ymhtwe/stm32_timer_app/HW/foot_prints/PEC11R-4215F-S0024/ec11_rotary_encoder_knob_-yf-19-1.snapshot.2/EC11_knob.jpg

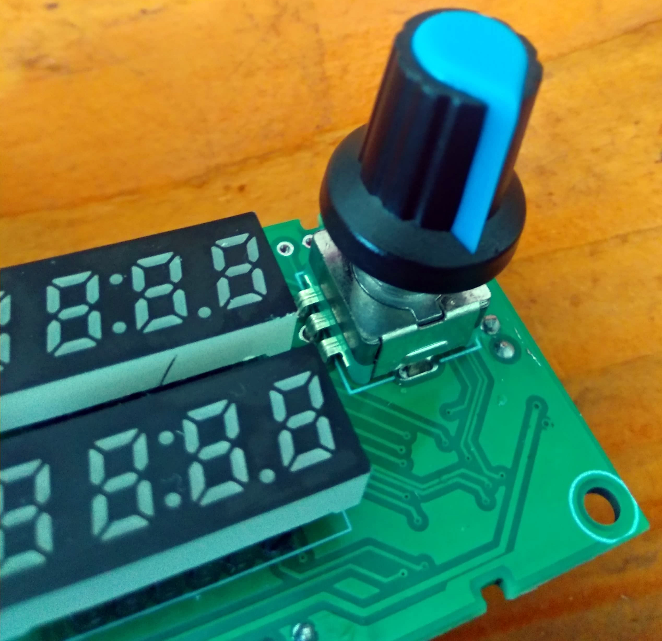
HW/foot_prints/PEC11R-4215F-S0024/ec11_rotary_encoder_knob_-yf-19-1.snapshot.2/EC11_knob.jpg
