ymhtwe/stm32_timer_app/HW/stm32_timer_app_front_pcb_layout.jpg

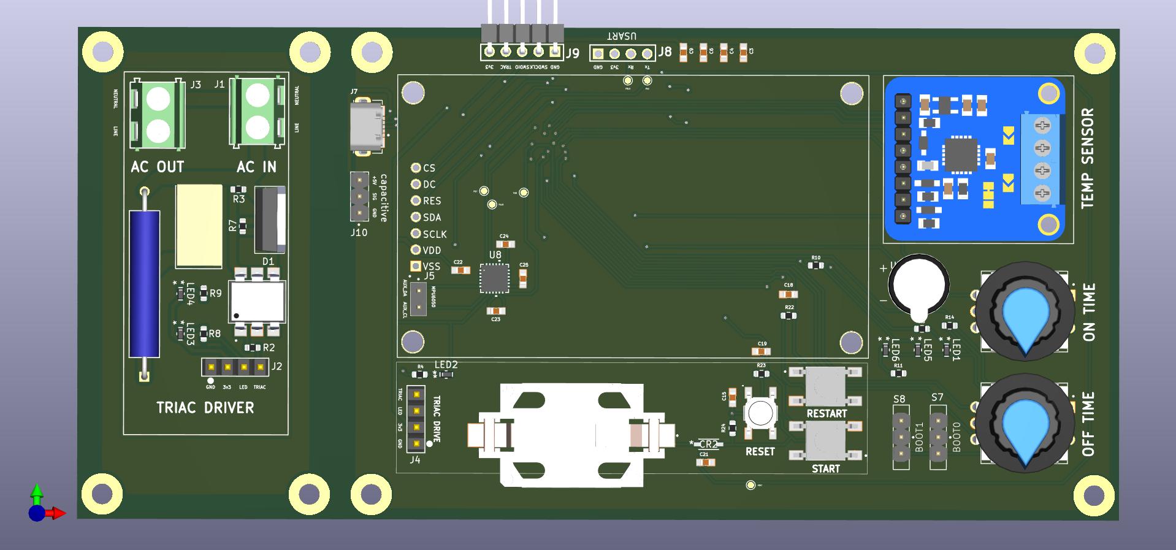
HW/stm32_timer_app_front_pcb_layout.jpg
