ymhtwe/stm32_timer_app/README.md

# stm32_timer_app
general purpose control applications using stm32 timer module
