ymhtwe/stm32_timer_app/Temp Control Timer.pdf

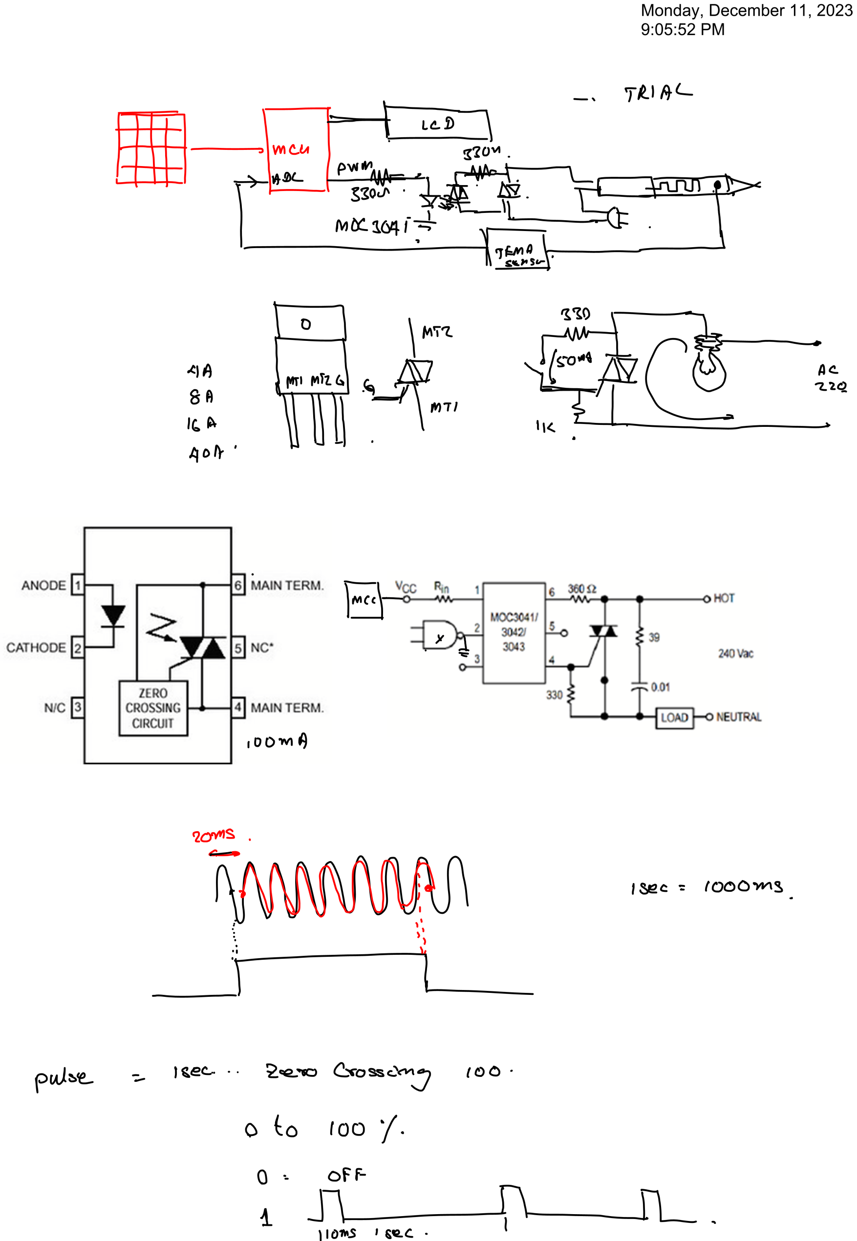
[picture p3: page 1]
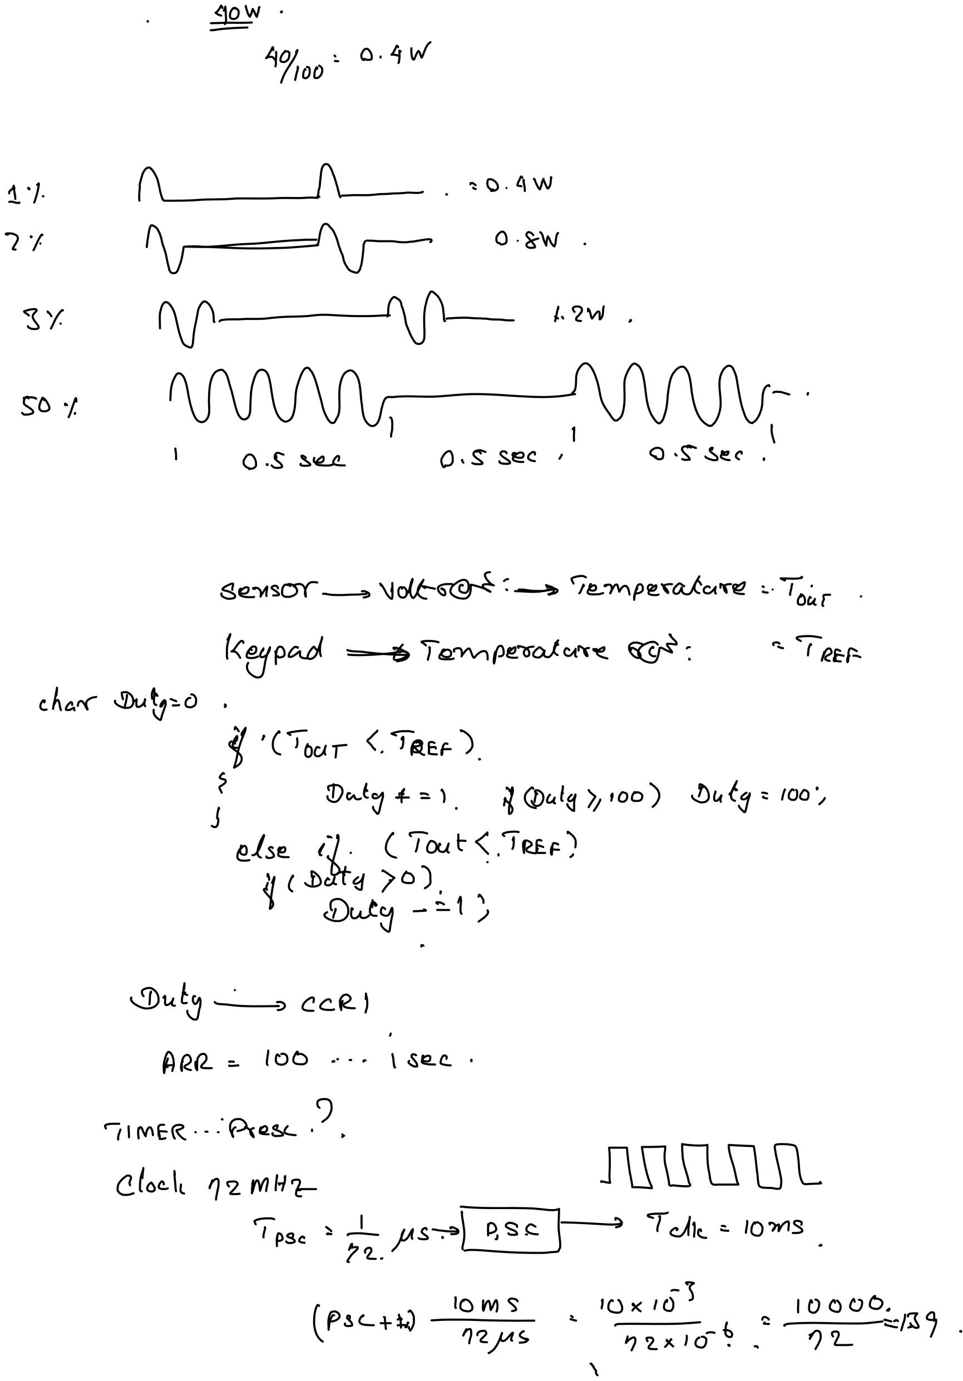
[picture p4: page 2]
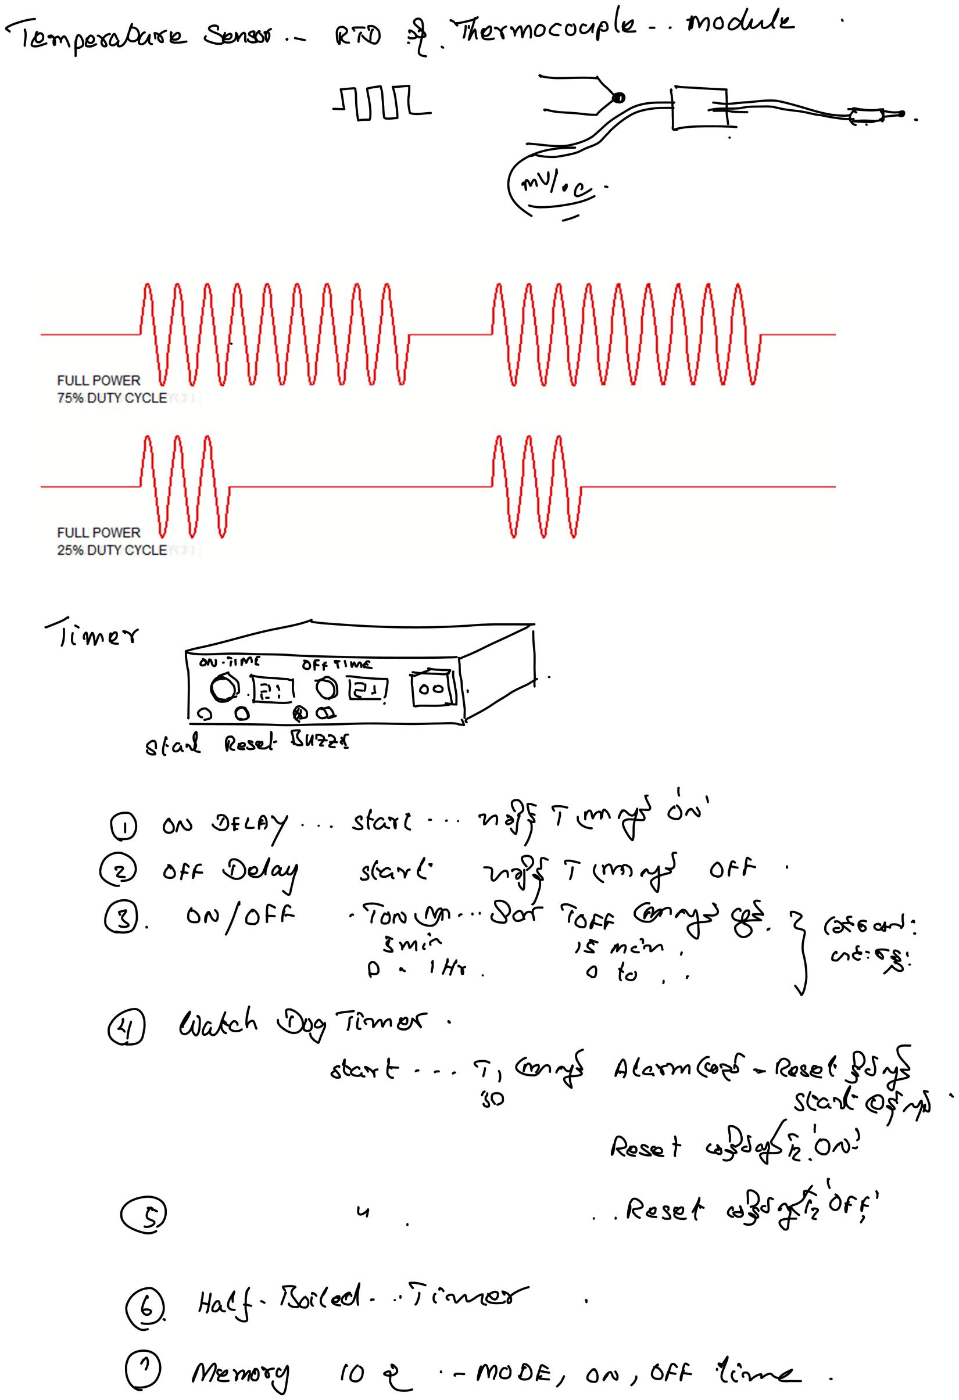
[picture p5: page 3]
