ymhtwe/stm32_timer_app/HW/stm32_timer_app/stm32_timer_app.jpg

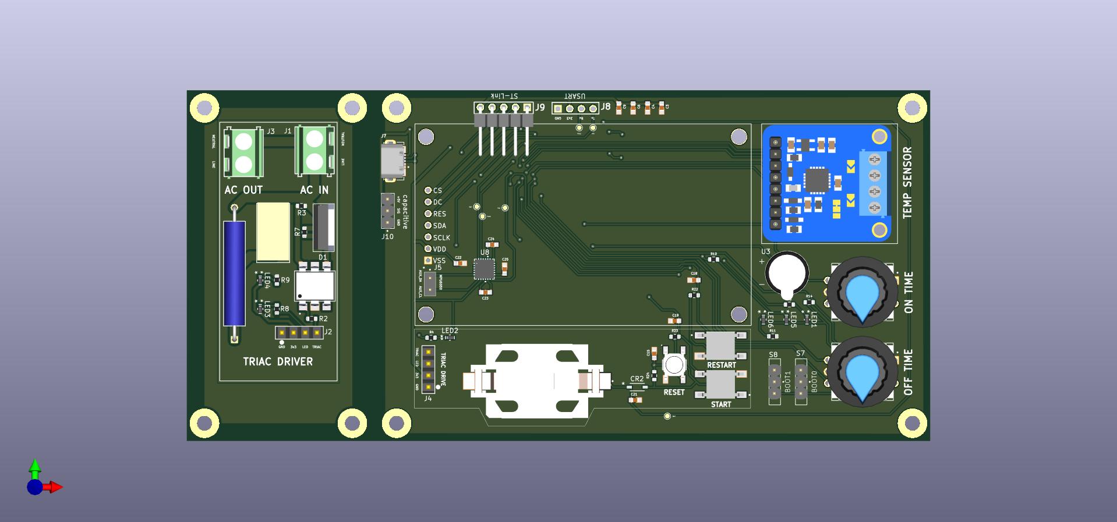
HW/stm32_timer_app/stm32_timer_app.jpg
