ymhtwe/stm32_timer_app/HW/foot_prints/150060GS75000/LED_150060GS75000_WRE.step

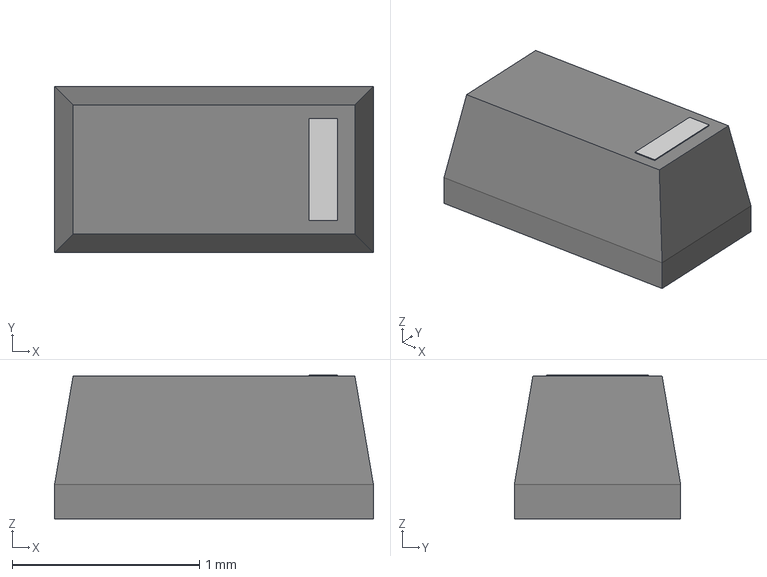
[picture p8: CAD file, 2023-12-16]
HW/foot_prints/150060GS75000/LED_150060GS75000_WRE.step
1.70 x 0.888 x 0.768 mm
