ymhtwe/stm32_timer_app/HW/foot_prints/1N4148W_13_F/SOD123_DIO.step

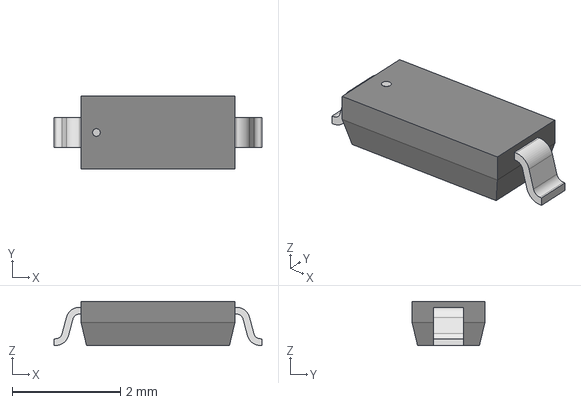
[picture p9: CAD file, 2023-12-17]
HW/foot_prints/1N4148W_13_F/SOD123_DIO.step
3.85 x 1.35 x 0.815 mm
