ymhtwe/stm32_timer_app/HW/foot_prints/2-42-12864-oled-display-1.snapshot.2/OLED 2.42 12864 v7.step

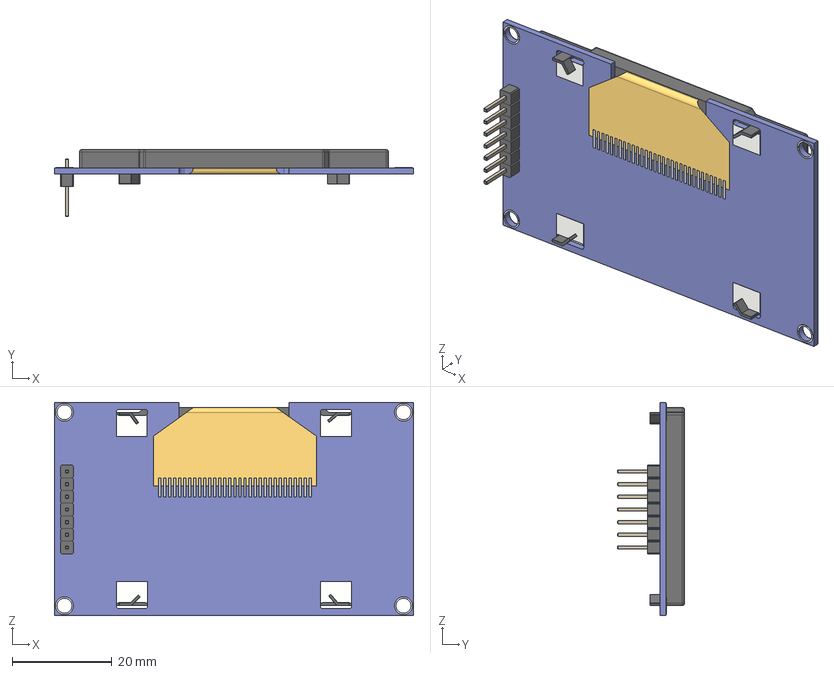
[picture p10: CAD file, 2023-12-21]
HW/foot_prints/2-42-12864-oled-display-1.snapshot.2/OLED 2.42 12864 v7.step
72.0 x 13.4 x 42.8 mm
screen
cable
PLS-7 v2
