ymhtwe/stm32_timer_app/HW/foot_prints/61300411121/CONN_61300411121_WRE.step

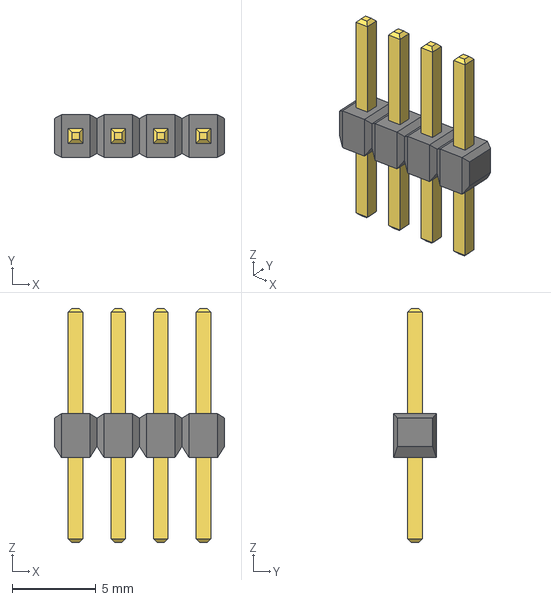
[picture p11: CAD file, 2023-12-16]
HW/foot_prints/61300411121/CONN_61300411121_WRE.step
10.2 x 2.54 x 14.0 mm
