ymhtwe/stm32_timer_app/HW/foot_prints/ABL-8.000MHZ-B2/ABL-8.000MHZ-B2.step

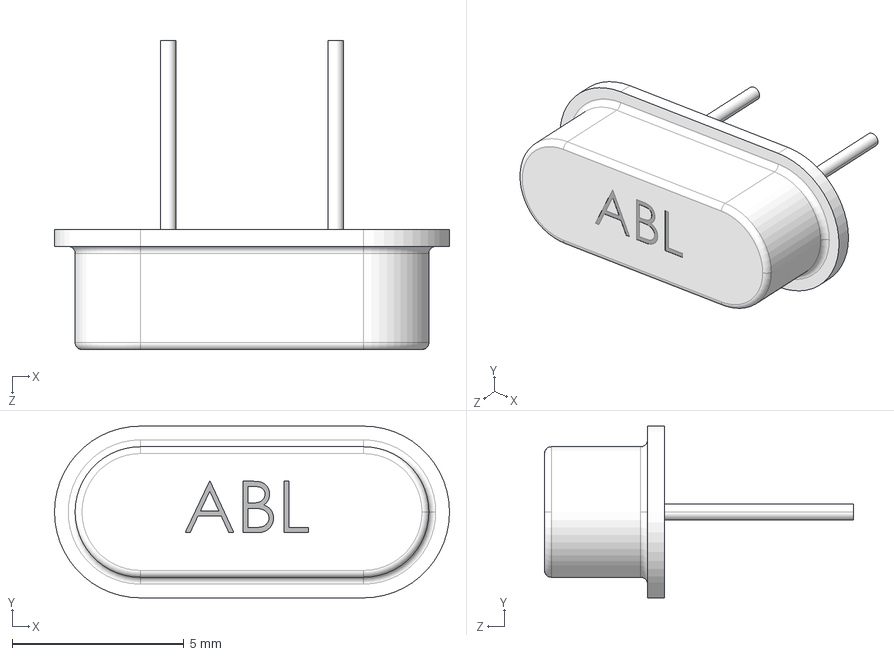
[picture p12: CAD file, 2023-12-17]
HW/foot_prints/ABL-8.000MHZ-B2/ABL-8.000MHZ-B2.step
11.5 x 5.00 x 9.00 mm
