ymhtwe/stm32_timer_app/HW/foot_prints/ABLS-8.000MHZ-B2-T/ABLS-8.000MHZ-B2-T.step

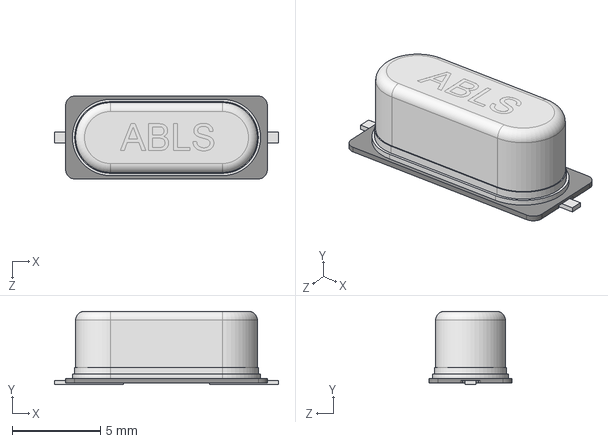
[picture p13: CAD file, 2023-12-21]
HW/foot_prints/ABLS-8.000MHZ-B2-T/ABLS-8.000MHZ-B2-T.step
12.7 x 4.17 x 4.70 mm
