ymhtwe/stm32_timer_app/HW/foot_prints/ABM3_8_000MHZ_J4Q_T/ABM3-8.000MHZ-J4Q-T.step

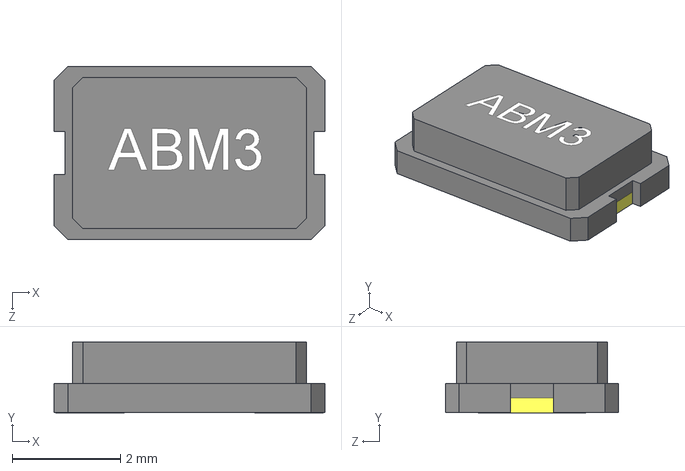
[picture p14: CAD file, 2023-12-25]
HW/foot_prints/ABM3_8_000MHZ_J4Q_T/ABM3-8.000MHZ-J4Q-T.step
5.00 x 1.30 x 3.20 mm
