ymhtwe/stm32_timer_app/HW/foot_prints/ABS07-32.768KHZ-T/ABS07-32.768KHZ-T.step

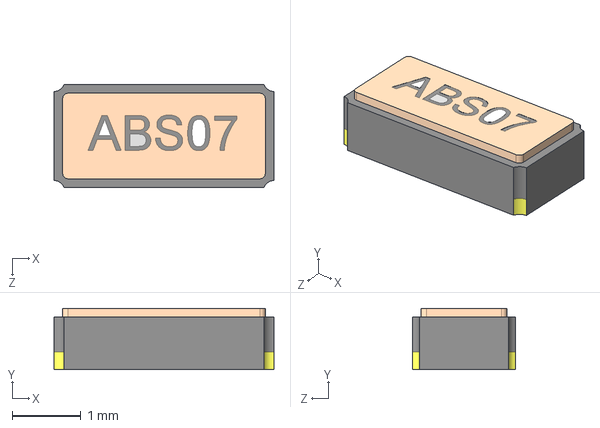
[picture p15: CAD file, 2023-12-25]
HW/foot_prints/ABS07-32.768KHZ-T/ABS07-32.768KHZ-T.step
3.20 x 0.889 x 1.50 mm
