ymhtwe/stm32_timer_app/HW/foot_prints/ABS25-32.768KHZ-6-4-T/ABS25-32.768KHZ-6-4-T.step

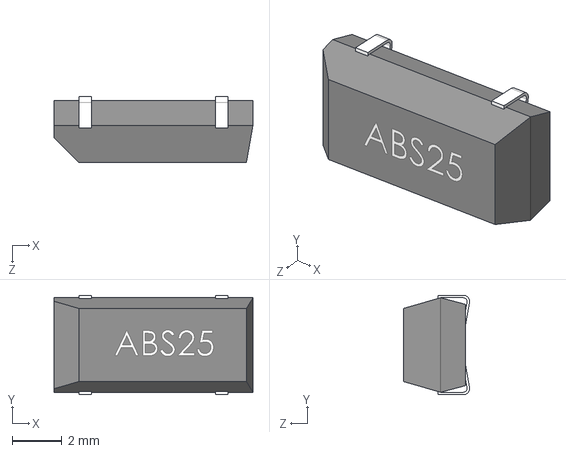
[picture p16: CAD file, 2023-12-17]
HW/foot_prints/ABS25-32.768KHZ-6-4-T/ABS25-32.768KHZ-6-4-T.step
8.00 x 4.00 x 2.66 mm
