ymhtwe/stm32_timer_app/HW/foot_prints/AI-1027-TWT-3V-R/AI-1027-TWT-3V-R.step

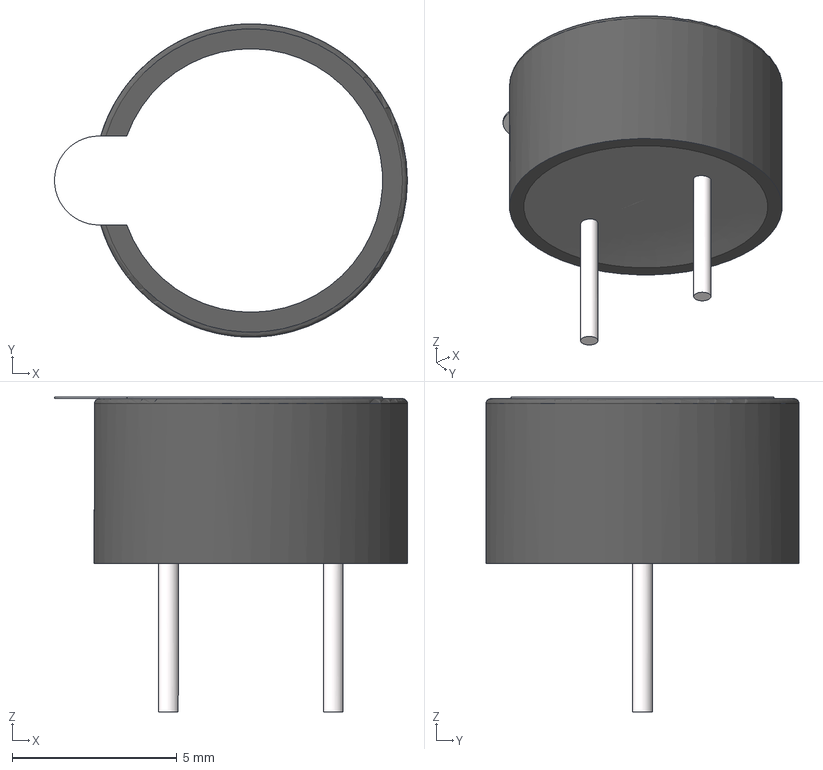
[picture p17: CAD file, 2023-12-23]
HW/foot_prints/AI-1027-TWT-3V-R/AI-1027-TWT-3V-R.step
10.7 x 9.50 x 9.55 mm
