ymhtwe/stm32_timer_app/HW/foot_prints/BTA16-600B/BTA16-600B.step

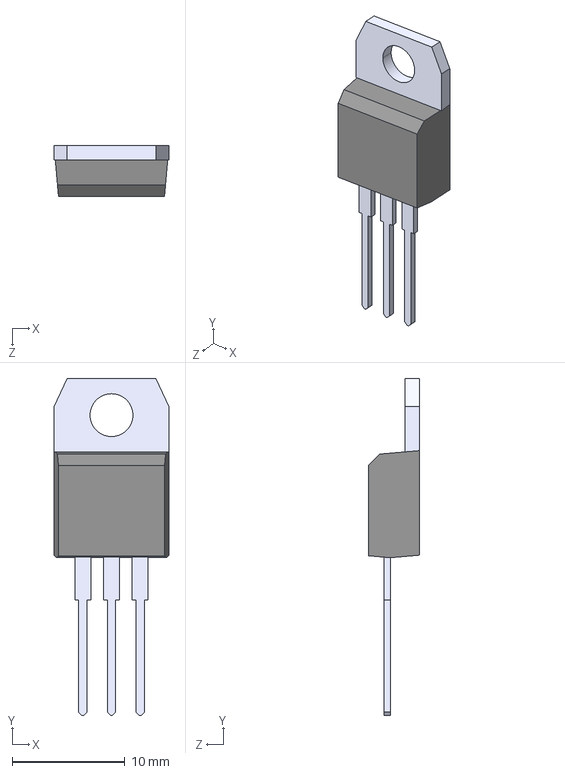
[picture p18: CAD file, 2023-12-16]
HW/foot_prints/BTA16-600B/BTA16-600B.step
10.2 x 29.9 x 4.50 mm
