ymhtwe/stm32_timer_app/HW/foot_prints/ECW_FD2J273KQ/CAP_ECWFD_FORMING_Q__12_6LX06_9TX09_9H_PAN.step

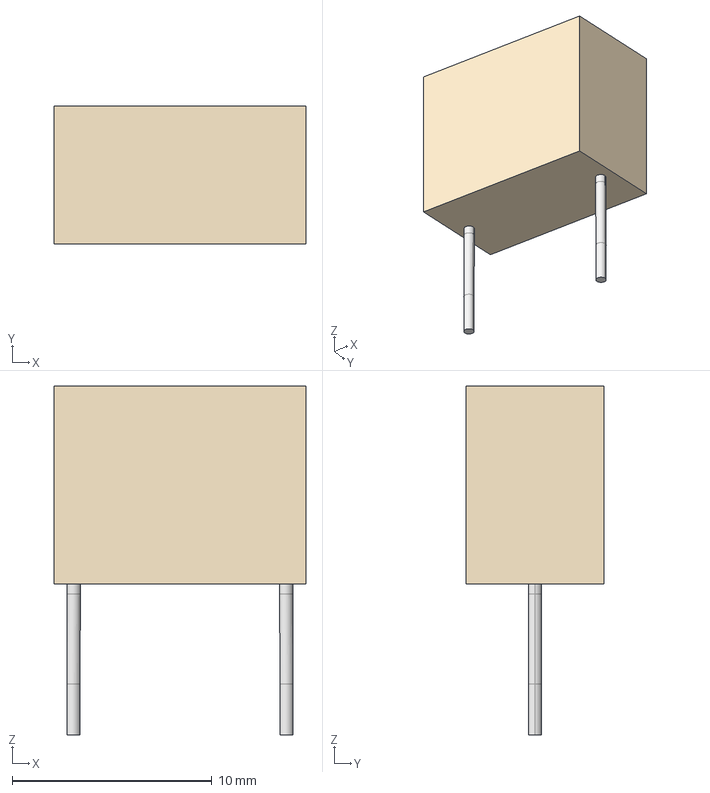
[picture p19: CAD file, 2023-12-17]
HW/foot_prints/ECW_FD2J273KQ/CAP_ECWFD_FORMING_Q__12_6LX06_9TX09_9H_PAN.step
12.6 x 6.91 x 17.4 mm
