ymhtwe/stm32_timer_app/HW/foot_prints/LD03ZD475MAB2A/LD03ZD475MAB2A.step

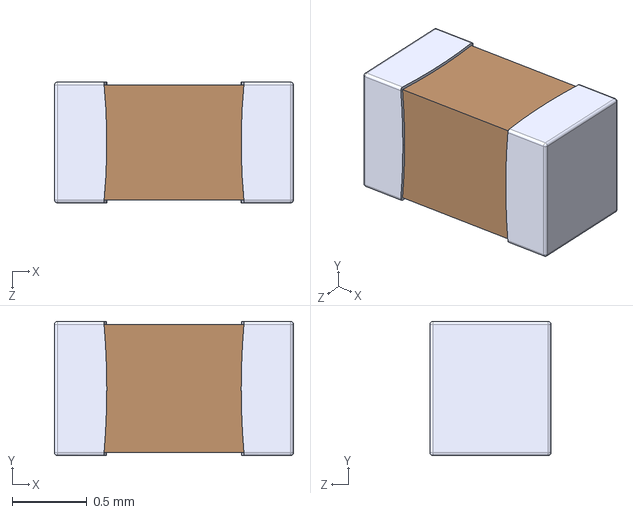
[picture p20: CAD file, 2023-12-16]
HW/foot_prints/LD03ZD475MAB2A/LD03ZD475MAB2A.step
1.60 x 0.9 x 0.81 mm
