ymhtwe/stm32_timer_app/HW/foot_prints/MMBT2222A-7-F/MMBT2222A-7-F.step

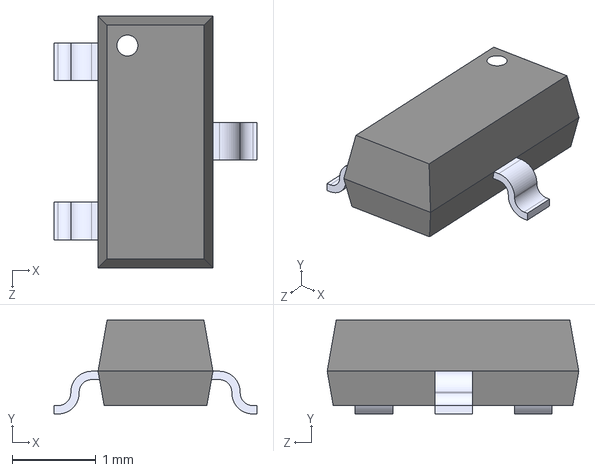
[picture p21: CAD file, 2023-12-23]
HW/foot_prints/MMBT2222A-7-F/MMBT2222A-7-F.step
2.42 x 1.12 x 3.00 mm
