ymhtwe/stm32_timer_app/HW/foot_prints/MOC3041/MOC3041.step

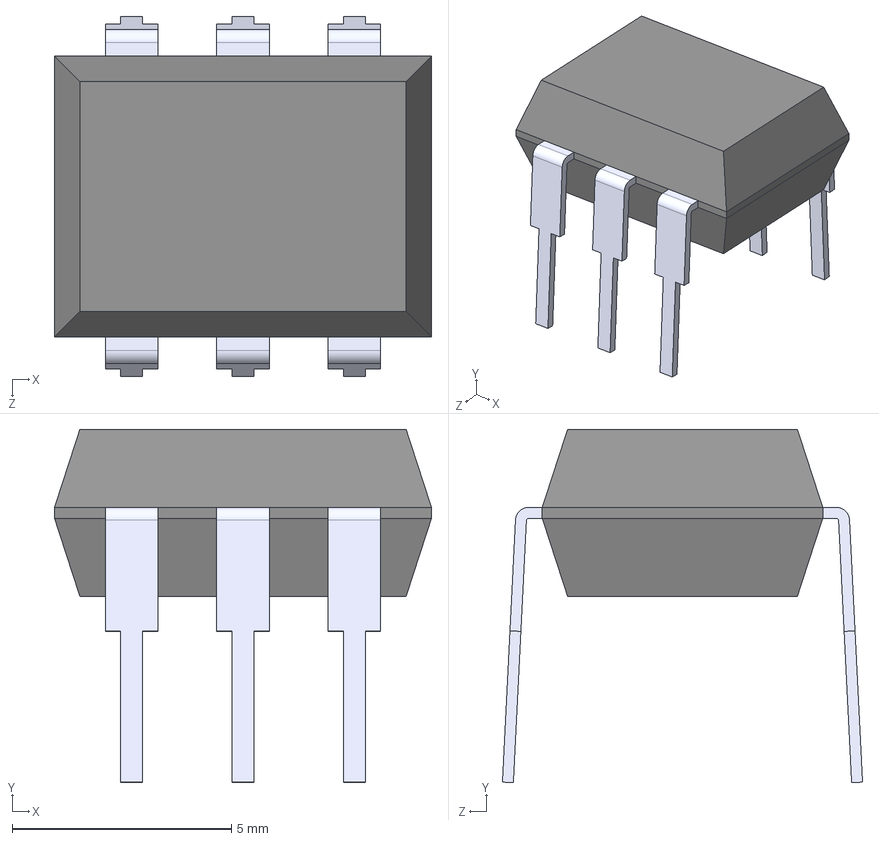
[picture p22: CAD file, 2023-12-16]
HW/foot_prints/MOC3041/MOC3041.step
8.60 x 8.06 x 8.21 mm
