ymhtwe/stm32_timer_app/HW/foot_prints/MOC3041SM/MOC3041SM.step

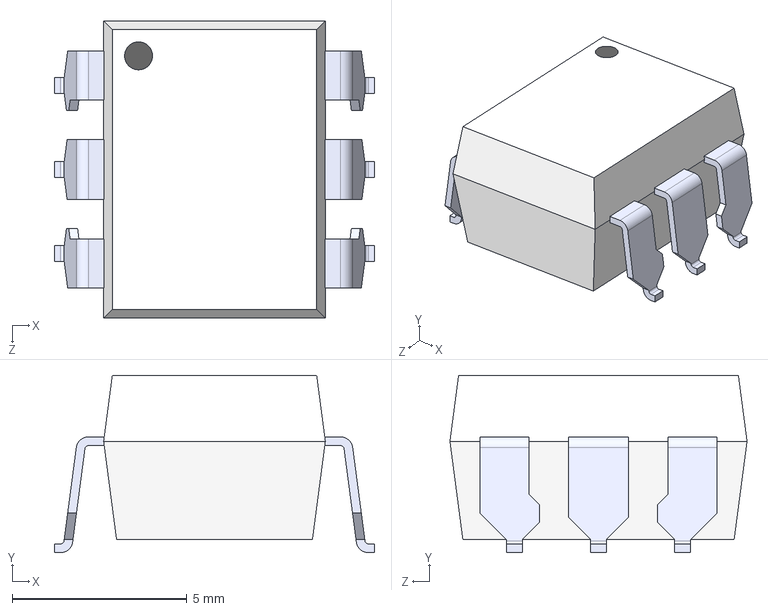
[picture p23: CAD file, 2023-12-16]
HW/foot_prints/MOC3041SM/MOC3041SM.step
9.16 x 5.08 x 8.51 mm
