ymhtwe/stm32_timer_app/HW/foot_prints/MPU_6050/QFN24_4X4X0P9_IVS.step

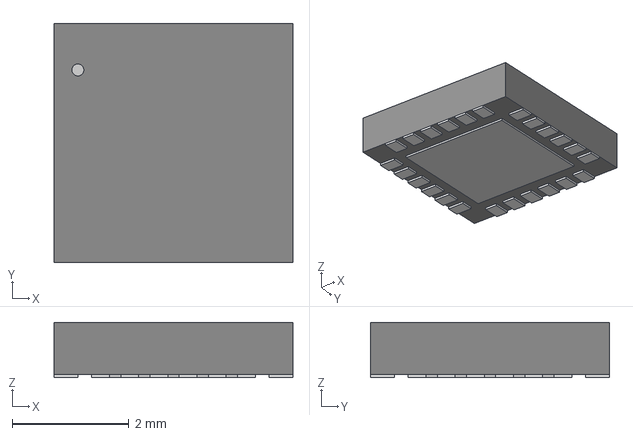
[picture p24: CAD file, 2024-01-13]
HW/foot_prints/MPU_6050/QFN24_4X4X0P9_IVS.step
4.09 x 4.09 x 0.942 mm
