ymhtwe/stm32_timer_app/HW/foot_prints/MSS-102559-14A-D/MSS-102559-14A-D.stp

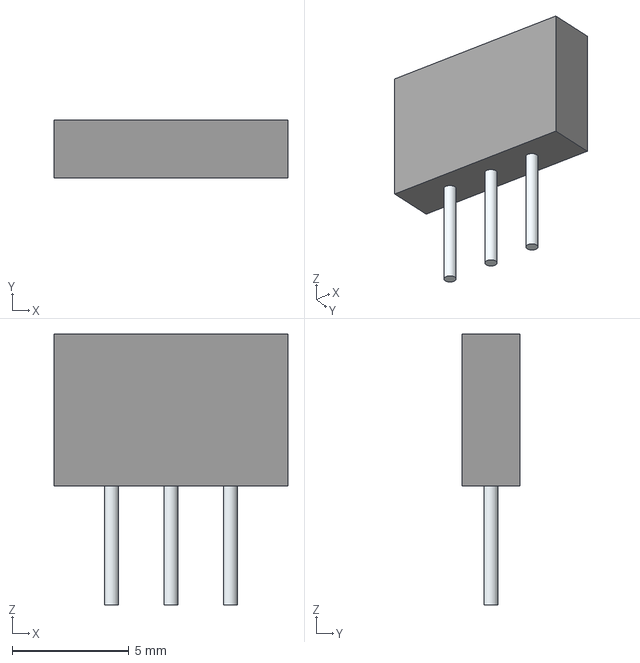
[picture p25: CAD file, 2023-12-25]
HW/foot_prints/MSS-102559-14A-D/MSS-102559-14A-D.stp
10.0 x 2.50 x 11.6 mm
Leads
