ymhtwe/stm32_timer_app/HW/foot_prints/MSS6-V-T_R/MSS6-V-T_R.step

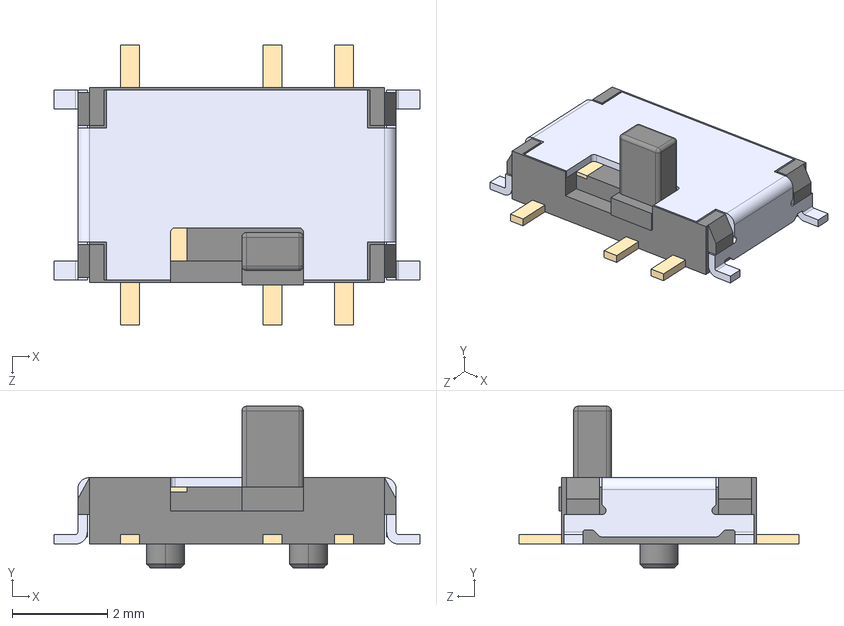
[picture p26: CAD file, 2023-12-21]
HW/foot_prints/MSS6-V-T_R/MSS6-V-T_R.step
7.70 x 3.40 x 5.90 mm
