ymhtwe/stm32_timer_app/HW/foot_prints/OY390KE/RES_OY_OHM.step

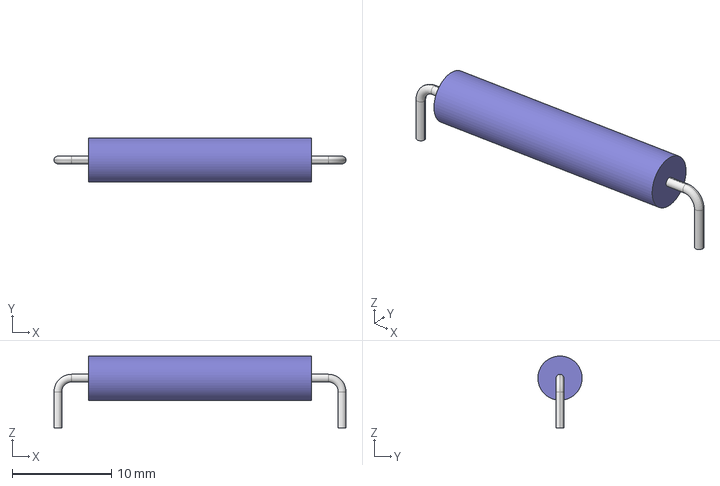
[picture p27: CAD file, 2023-12-17]
HW/foot_prints/OY390KE/RES_OY_OHM.step
29.5 x 4.47 x 7.26 mm
