ymhtwe/stm32_timer_app/HW/foot_prints/PEC11R-4215F-S0024/ec11_rotary_encoder_knob_-yf-19-1.snapshot.2/EC11_rotary_encoder_knob/EC11_rotary_encoder_knob.stp

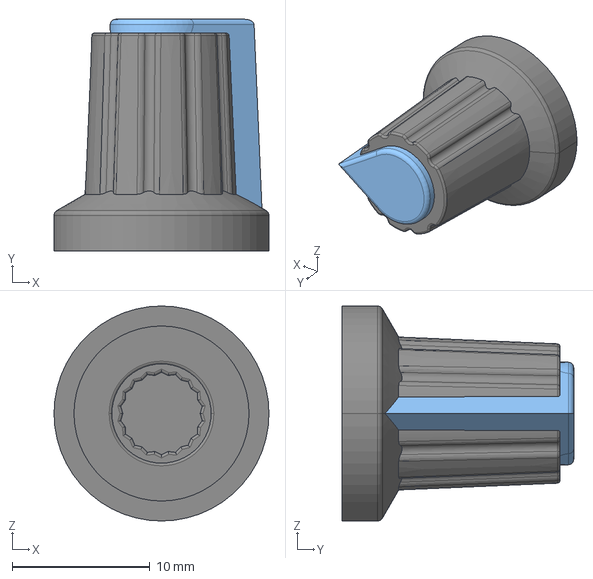
[picture p28: CAD file, 2023-12-25]
HW/foot_prints/PEC11R-4215F-S0024/ec11_rotary_encoder_knob_-yf-19-1.snapshot.2/EC11_rotary_encoder_knob/EC11_rotary_encoder_knob.stp
15.6 x 16.8 x 15.6 mm
