ymhtwe/stm32_timer_app/HW/foot_prints/PEC11R-4215F-S0024/PEC11R-4215F-S0024.step

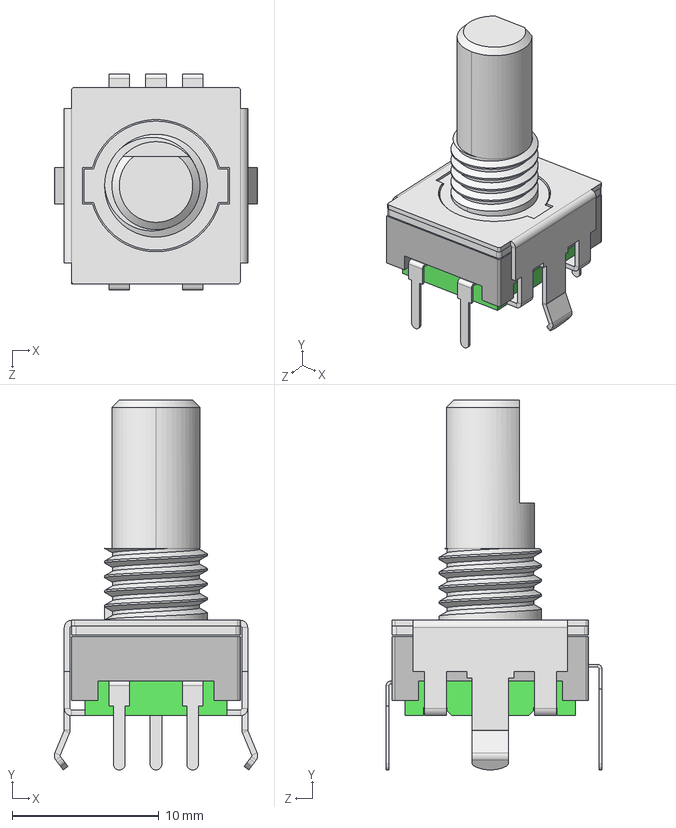
[picture p29: CAD file, 2023-12-16]
HW/foot_prints/PEC11R-4215F-S0024/PEC11R-4215F-S0024.step
13.9 x 25.2 x 14.7 mm
