ymhtwe/stm32_timer_app/HW/foot_prints/PH1RB-04-UA/PH1RB-04-UA.stp

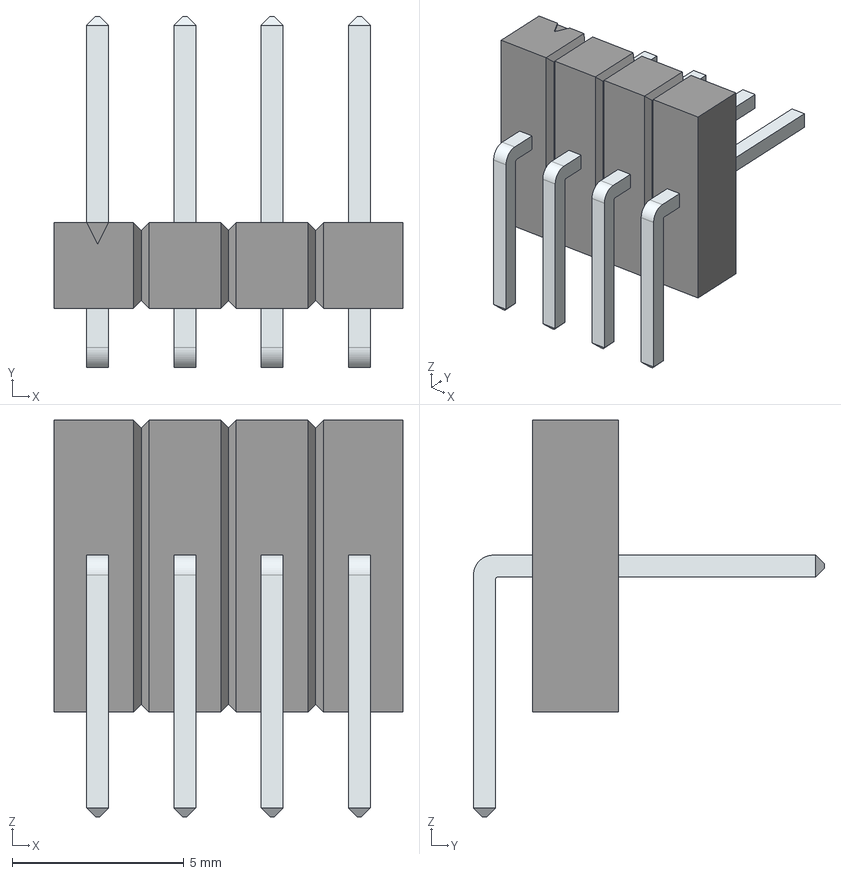
[picture p30: CAD file, 2024-01-13]
HW/foot_prints/PH1RB-04-UA/PH1RB-04-UA.stp
10.2 x 10.2 x 11.6 mm
LeadsArray
