ymhtwe/stm32_timer_app/HW/foot_prints/PH1RB-05-UA_TEMP/PH1RB-05-UA_TEMP..stp

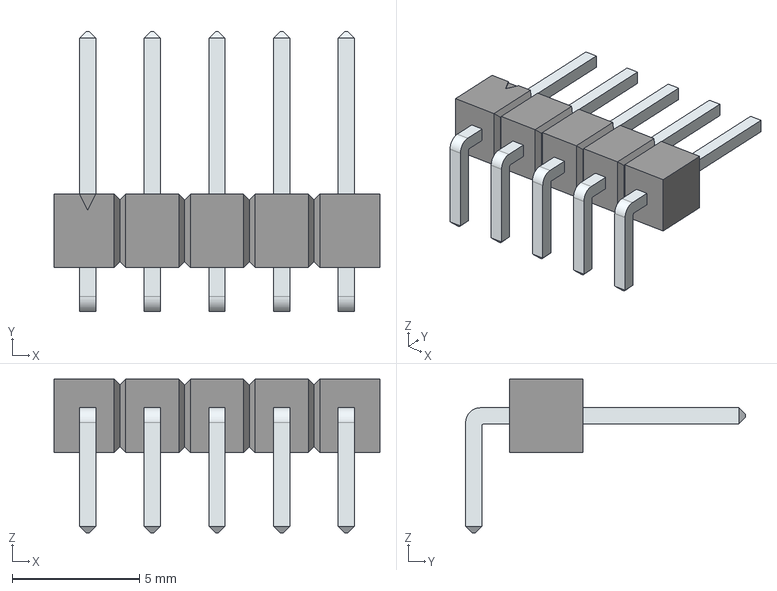
[picture p31: CAD file, 2024-01-13]
HW/foot_prints/PH1RB-05-UA_TEMP/PH1RB-05-UA_TEMP..stp
12.8 x 11.0 x 6.03 mm
LeadsArray
