ymhtwe/stm32_timer_app/HW/foot_prints/PH2_06_UA/CONN_PH2-06-UA_ADM.step

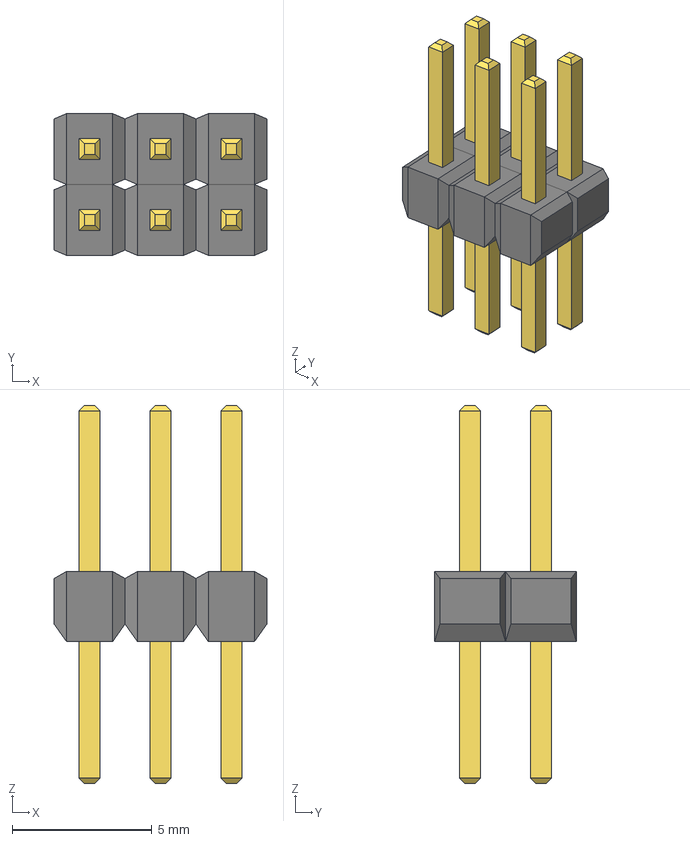
[picture p32: CAD file, 2023-12-16]
HW/foot_prints/PH2_06_UA/CONN_PH2-06-UA_ADM.step
7.62 x 5.08 x 13.5 mm
