ymhtwe/stm32_timer_app/HW/foot_prints/RC1206FR_0728RL/RC1206N_YAG.step

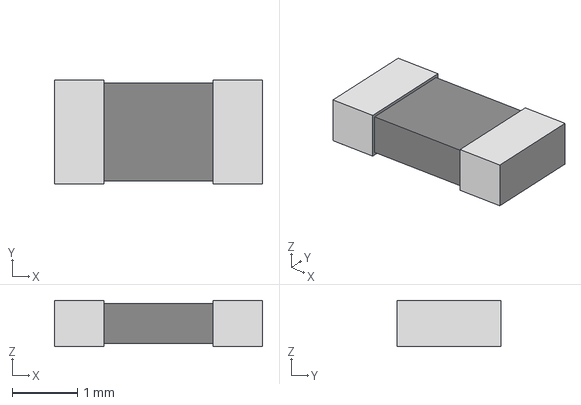
[picture p33: CAD file, 2024-01-13]
HW/foot_prints/RC1206FR_0728RL/RC1206N_YAG.step
3.20 x 1.60 x 0.711 mm
