ymhtwe/stm32_timer_app/HW/foot_prints/RC1602B-BIW-CSV/RC1602B-BIW-CSV.step

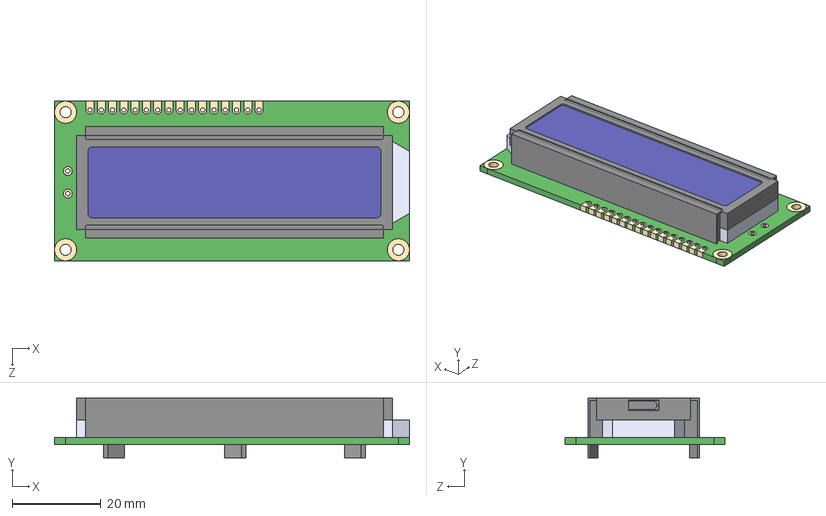
[picture p34: CAD file, 2023-12-16]
HW/foot_prints/RC1602B-BIW-CSV/RC1602B-BIW-CSV.step
80.0 x 13.5 x 36.0 mm
