ymhtwe/stm32_timer_app/HW/foot_prints/RT9193_33GB/RT9193-33GB.step

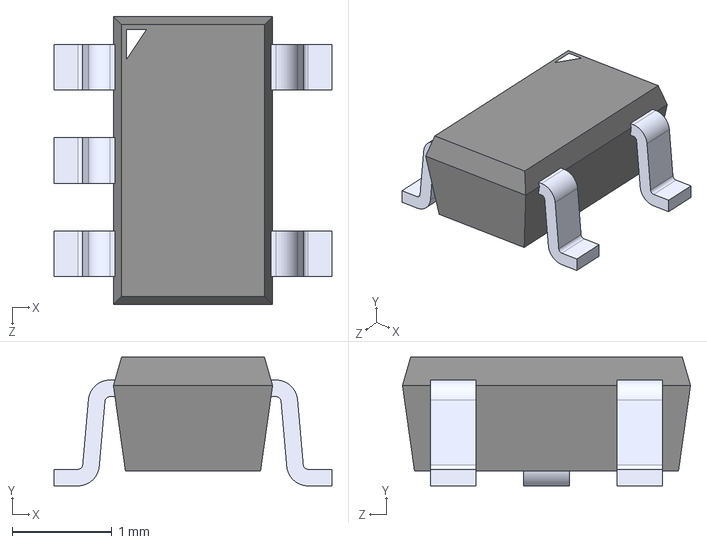
[picture p35: CAD file, 2023-12-16]
HW/foot_prints/RT9193_33GB/RT9193-33GB.step
2.79 x 1.30 x 2.90 mm
