ymhtwe/stm32_timer_app/HW/foot_prints/SMTU2032-LF/SMTU2032.step

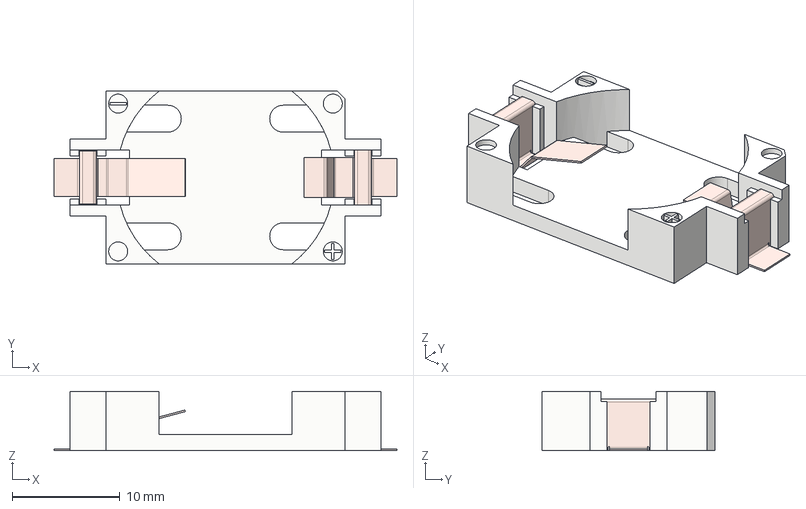
[picture p36: CAD file, 2023-12-28]
HW/foot_prints/SMTU2032-LF/SMTU2032.step
31.8 x 16.0 x 5.50 mm
base
connector_plus
connector_minus
