ymhtwe/stm32_timer_app/HW/foot_prints/STM32F103C8T6/STM32F103C8T6--3DModel-STEP-510211.STEP

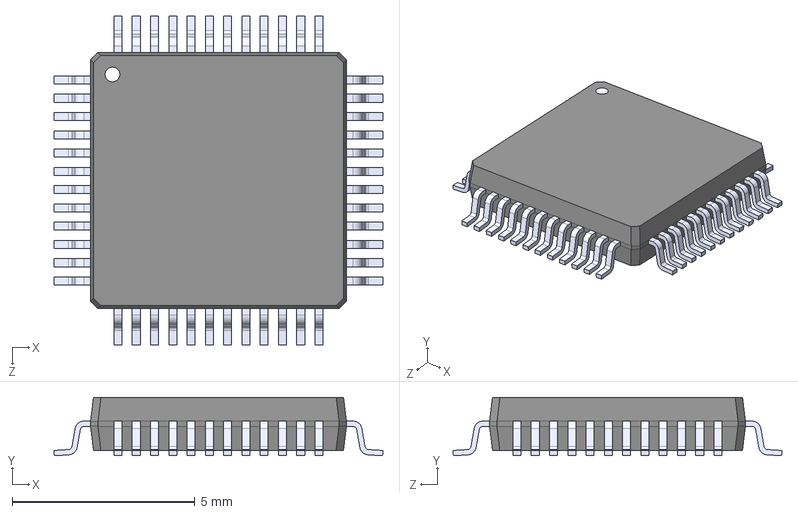
[picture p37: CAD file, 2023-12-16]
HW/foot_prints/STM32F103C8T6/STM32F103C8T6--3DModel-STEP-510211.STEP
9.00 x 1.60 x 9.00 mm
