ymhtwe/stm32_timer_app/HW/foot_prints/STM32f303C8T6/STM32F303C8T6.stp

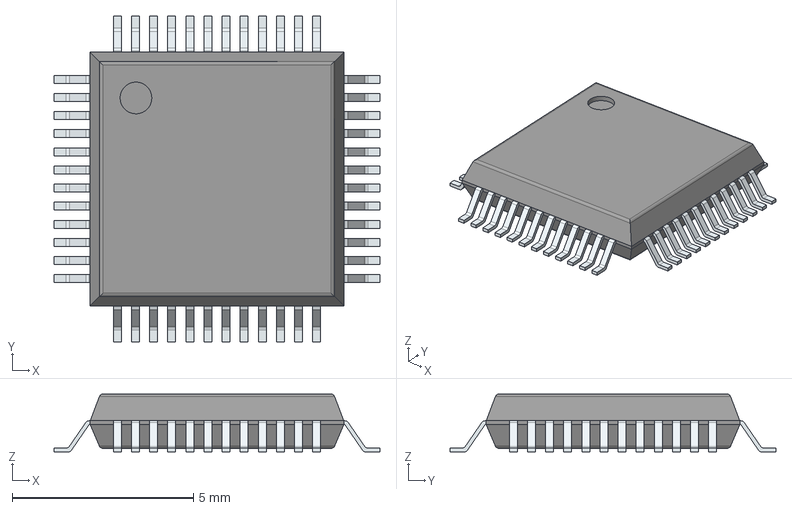
[picture p38: CAD file, 2023-12-28]
HW/foot_prints/STM32f303C8T6/STM32F303C8T6.stp
9.00 x 9.00 x 1.60 mm
PinsArrayLR
PinsArrayTB
