ymhtwe/stm32_timer_app/HW/foot_prints/TC33X_2_102E/TC33X-2-102E.step

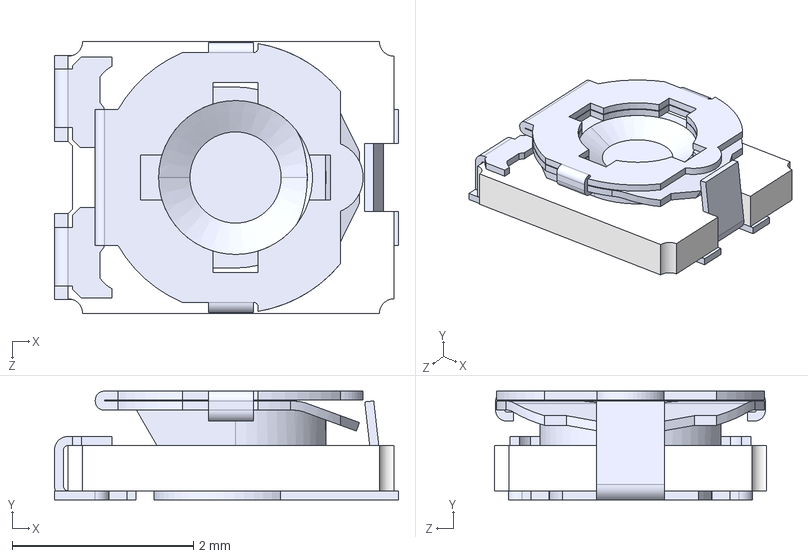
[picture p39: CAD file, 2023-12-17]
HW/foot_prints/TC33X_2_102E/TC33X-2-102E.step
3.80 x 1.20 x 3.00 mm
