ymhtwe/stm32_timer_app/HW/foot_prints/TL3342F160QG/TL3342F160QG.step

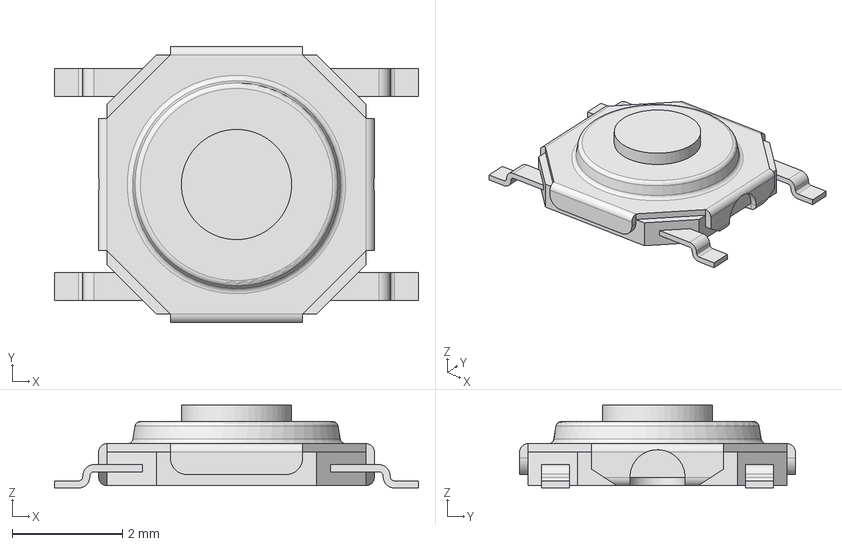
[picture p40: CAD file, 2023-12-21]
HW/foot_prints/TL3342F160QG/TL3342F160QG.step
6.60 x 5.00 x 1.50 mm
