ymhtwe/stm32_timer_app/HW/foot_prints/PH1RB-05-UA_TEMP/PH1RB-05-UA.STL

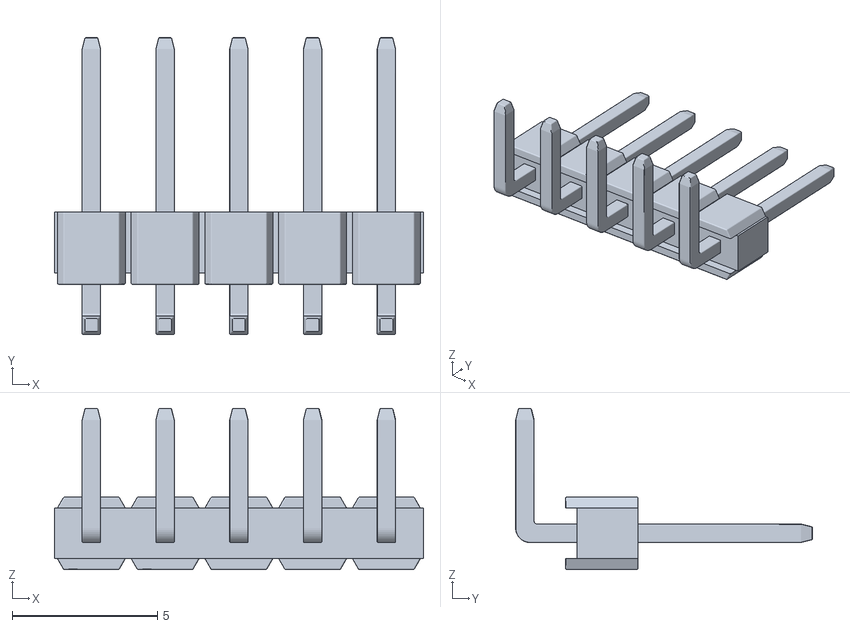
[picture p41: CAD file, 2024-01-13]
HW/foot_prints/PH1RB-05-UA_TEMP/PH1RB-05-UA.STL
12.7 x 10.2 x 5.55
