ymhtwe/stm32_timer_app/(list of files, cad)

Other CAD files:
HW/foot_prints/PTS526_SM15_SMTR2_LFS/PTS526SM15SMTR2LFS.stp
HW/foot_prints/1050170001/1050170001--3DModel-STEP-1.STEP
HW/foot_prints/105164-0001/105164-0001.step
HW/foot_prints/1571527-1/1571527-1.step
HW/foot_prints/54101-G0502LF/54101-G0502LF.step
HW/foot_prints/691213710002/691213710002.stp
HW/foot_prints/75160-196-03LF/75160-196-03LF.step
HW/foot_prints/78511-202/78511-202.step
HW/foot_prints/AOM12864A0-1.54WW-ANO/AOM12864A0-1.54WW-ANO.step
HW/foot_prints/MAX31865/MAX31865.stp
HW/foot_prints/PEC11R-4215F-S0024/ec11_rotary_encoder_knob_-yf-19-1.snapshot.2/EC11_rotary_encoder_knob/EC11_rotary_encoder_knob.igs
HW/foot_prints/PTS526_SM15_SMTR2_LFS/PTS526SM15SMTR2LFS.STL
