ymhtwe/stm32_timer_app/stm32_timer_app.pdf

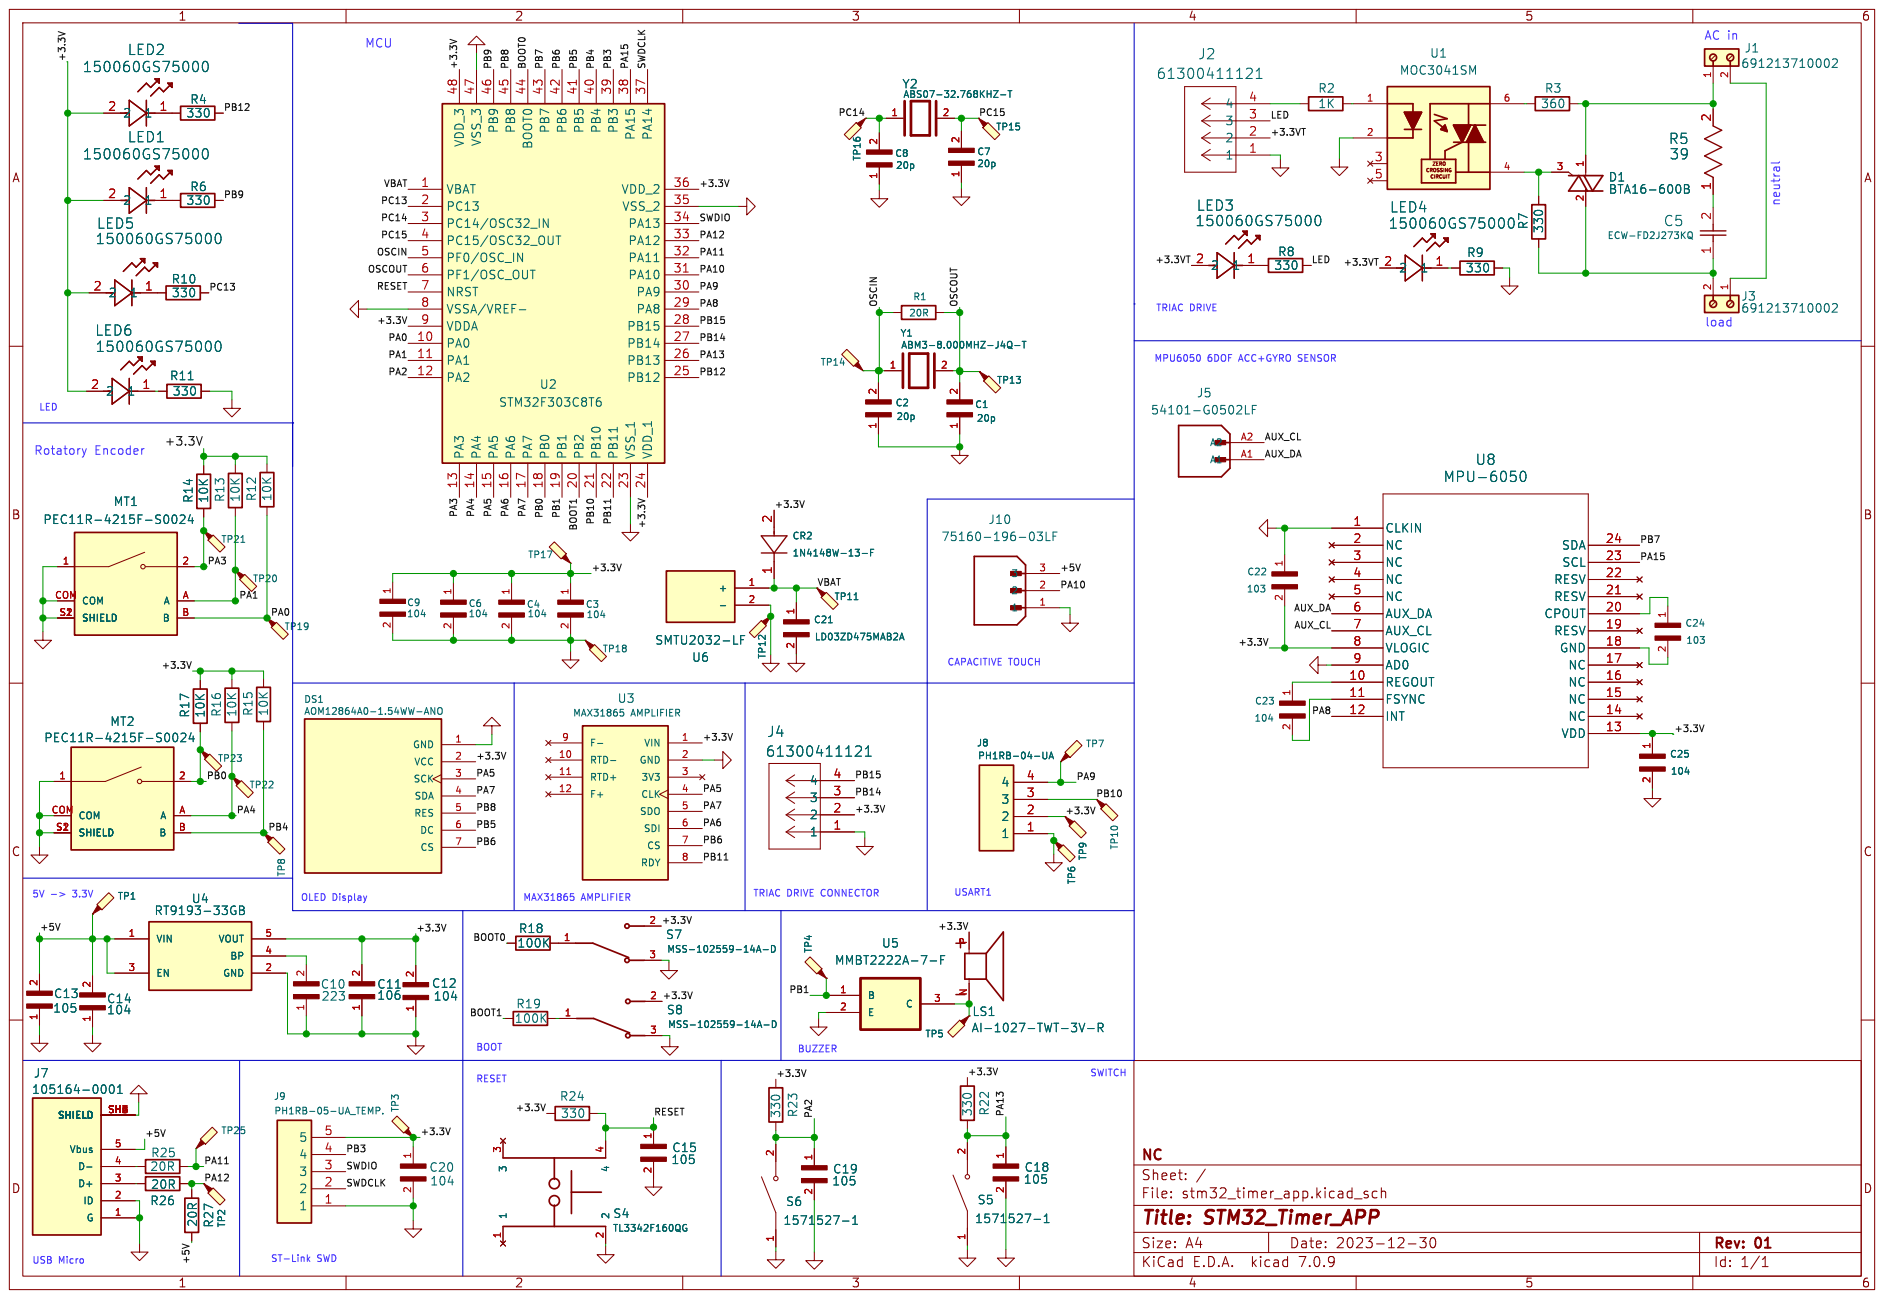
[picture p42: page 1]
