ymhtwe/stm32_timer_app/HW/stm32_timer_app/stm32_timer_app.kicad_pcb

## KiCad design HW/stm32_timer_app/stm32_timer_app.kicad_pcb (2024-01-13)

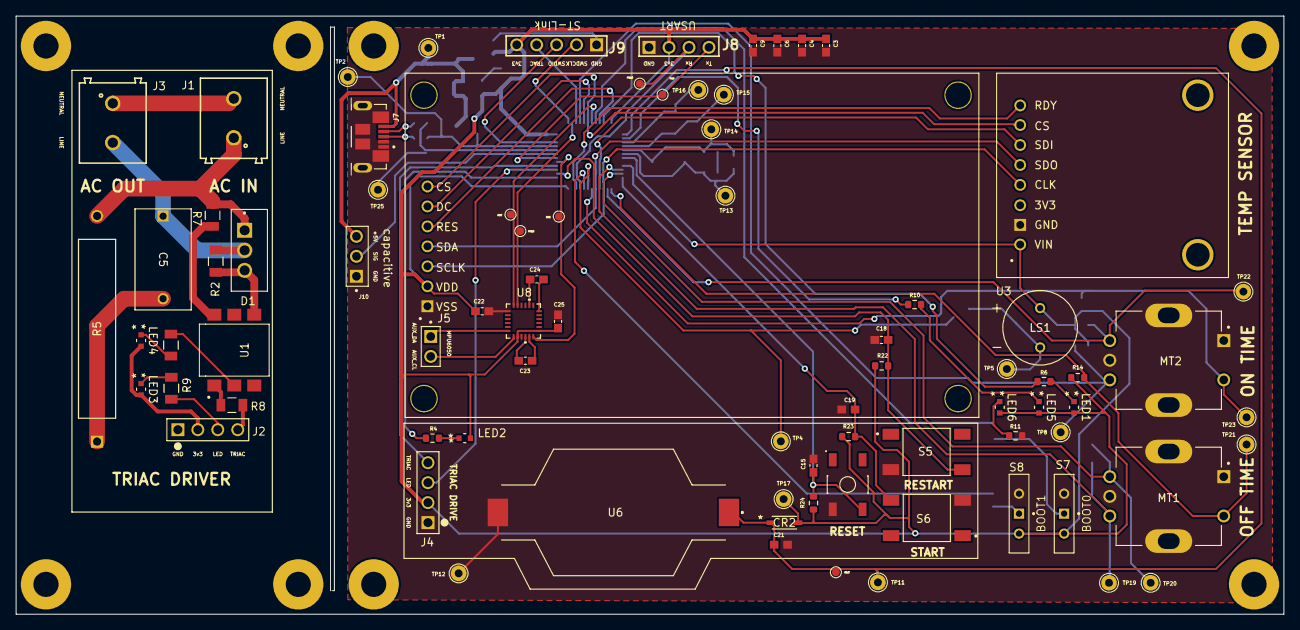
[picture p43: board stm32_timer_app.kicad_pcb from above]

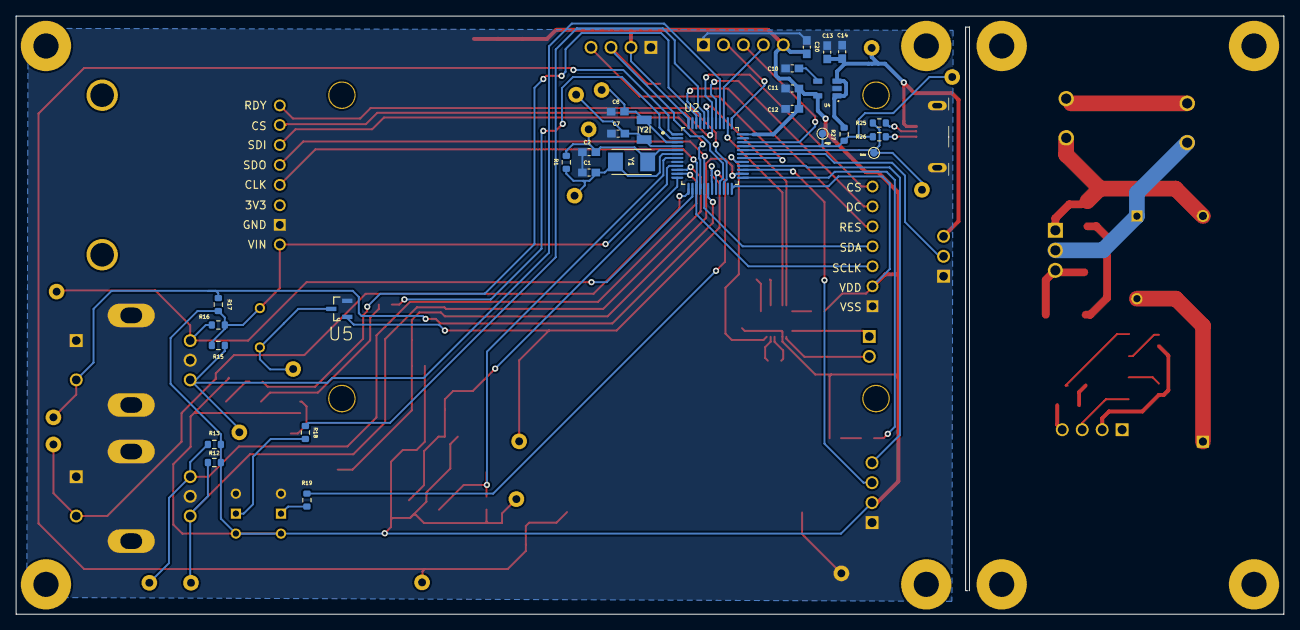
[picture p44: board stm32_timer_app.kicad_pcb from below]

Board: 2 copper layers, 161.3 x 76.1 mm, 101 parts (26 on the bottom side), 71 nets.

Parts:
C1, C2, C7, C8: 20p; CAPC1608X90
C3, C4, C6, C9, C12, C14, C20, C23, C25: 104; CAPC1608X90
C5: ECW-FD2J273KQ; CAP_ECWFD_FORMINGQ_12.6LX06.9TX09.9H_PAN
C10: 223; CAPC1608X90
C11: 106; CAPC1608X90
C13, C15, C18, C19: 105; CAPC1608X90
C21: LD03ZD475MAB2A; CAPC1608X90
C22, C24: 103; CAPC1608X90
CR2: 1N4148W-13-F; SOD123_DIO
D1: BTA16-600B; TO255P1040X460X1975-3
DS1: AOM12864A0-1.54WW-ANO; LCD_AOM12864A0-1.54WW-ANO
J1, J3: 691213710002
J2, J4: 61300411121; CONN_61300411121_WRE
J5: 54101-G0502LF; AMPHENOL_54101-G0502LF
J7: 105164-0001; MOLEX_105164-0001
J8: PH1RB-04-UA; HDRRA4W64P0X254_1X4_1016X250X850P
J9: PH1RB-05-UA_TEMP.; HDRRA5W64P0X254_1X5_1270X250X288P
J10: 75160-196-03LF; AMPHENOL_75160-196-03LF
LED1, LED2, LED3, LED4, LED5, LED6: 150060GS75000; LED_150060GS75000_WRE
LS1: AI-1027-TWT-3V-R; XDCR_AI-1027-TWT-3V-R
MT1, MT2: PEC11R-4215F-S0024; XDCR_PEC11R-4215F-S0024
R1, R25, R26, R27: 20R; R_0603_1608Metric
R2, R7, R9, R20: 330; RC1206N_YAG
R4, R6, R10, R11, R22, R23, R24: 330; R_0603_1608Metric
R5: 39; RES_OY_OHM
R8: 1k; RC1206N_YAG
R12, R13, R14, R15, R16, R17: 10K; R_0603_1608Metric
R18, R19: 100K; R_0603_1608Metric
S4: TL3342F160QG; SW_TL3342F160QG
S5, S6: 1571527-1; SW_1571527-1
S7, S8: MSS-102559-14A-D; SW_MSS-102559-14A-D
TP1, TP2, TP4, TP5, TP8, TP11, TP12, TP13, TP14, TP15, TP16, TP17, TP19, TP20, TP21, TP22, TP23, TP25: TestPoint_Probe; TestPoint_THTPad_D2.0mm_Drill1.0mm
U1: MOC3041SM; OPTO_MOC3041SM
U2: STM32F303C8T6; QFP50P900X900X160-48N
U3: MAX31865 AMPLIFIER; MAX31865
U4: RT9193-33GB; SOT94P279X129-5N
U5: MMBT2222A-7-F; SOT103P240X110-3N
U6: SMTU2032-LF; SMTU2032LF
U8: MPU-6050; QFN24_4X4X0P9_IVS
Y1: ABM3-8.000MHZ-J4Q-T; XTAL_ABM3-8.000MHZ-J4Q-T
Y2: ABS07-32.768KHZ-T; XTAL_ABS07-32.768KHZ-T

Connections:
/+3.3V: C3.1, C4.1, C6.1, C9.1, C11.2, C12.2, C20.1, C22.2, C25.1, CR2.2, DS1.2 (VCC), J4.2, J8.2, J9.5, LED1.2, LED2.2, LED5.2, LED6.2, LS1.P, R12.2, R13.2, R14.2, R15.2, R16.2, R17.2, R22.2, R23.2, R24.2, S7.2, S8.2, TP17.1, U2.9 (VDDA), U2.24 (VDD_1), U2.36 (VDD_2), U2.48 (VDD_3), U3.1 (VIN), U4.5 (VOUT), U8.8 (VLOGIC), U8.13 (VDD)
/+3.3VT: J2.2, LED3.2, LED4.2
/+5V: C13.2, C14.2, J7.5 (Vbus), J10.3, R27.1, TP1.1, U4.1 (VIN), U4.3 (EN)
/AUX_CL: J5.A2, U8.7 (AUX_CL)
/AUX_DA: J5.A1, U8.6 (AUX_DA)
/BOOT0: R18.2, U2.44 (BOOT0)
/BOOT1: R19.2, U2.20 (PB2)
/LED: J2.3, R9.1
/OSCIN: C2.2, R1.1, TP14.1, U2.5 (PF0/OSC_IN), Y1.1
/OSCOUT: C1.2, R1.2, TP13.1, U2.6 (PF1/OSC_OUT), Y1.2
/PA0: MT1.B, R12.1, TP19.1, U2.10 (PA0)
/PA1: MT1.A, R13.1, TP20.1, U2.11 (PA1)
/PA2: C19.1, R23.1, S6.4, U2.12 (PA2)
/PA3: MT1.2, R14.1, TP21.1, U2.13 (PA3)
/PA4: MT2.A, R16.1, TP22.1, U2.14 (PA4)
/PA5: DS1.3 (SCK), U2.15 (PA5), U3.4 (CLK)
/PA6: U2.16 (PA6), U3.6 (SDI)
/PA7: DS1.4 (SDA), U2.17 (PA7), U3.5 (SDO)
/PA8: U2.29 (PA8), U8.12 (INT)
/PA9: J8.4, U2.30 (PA9)
/PA10: J10.2, U2.31 (PA10)
/PA11: R25.2, TP25.1, U2.32 (PA11)
/PA12: R26.2, R27.2, TP2.1, U2.33 (PA12)
/PA13: C18.1, R22.1, S5.4, U2.26 (PB13)
/PA15: U2.38 (PA15), U8.23 (SCL)
/PB0: MT2.2, R17.1, TP23.1, U2.18 (PB0)
/PB1: TP4.1, U2.19 (PB1), U5.1 (B)
/PB3: J9.4, U2.39 (PB3)
/PB4: MT2.B, R15.1, TP8.1, U2.40 (PB4)
/PB5: DS1.6 (DC), U2.41 (PB5)
/PB6: DS1.7 (CS), U2.42 (PB6), U3.7 (CS)
/PB7: U2.43 (PB7), U8.24 (SDA)
/PB8: DS1.5 (RES), U2.45 (PB8)
/PB9: R6.1, U2.46 (PB9)
/PB10: J8.3, U2.21 (PB10)
/PB11: U2.22 (PB11), U3.8 (RDY)
/PB12: R4.1, U2.25 (PB12)
/PB14: J4.3, U2.27 (PB14)
/PB15: J4.4, U2.28 (PB15)
/PC13: R10.1, U2.2 (PC13)
/PC14: C8.2, TP16.1, U2.3 (PC14/OSC32_IN), Y2.1
/PC15: C7.2, TP15.1, U2.4 (PC15/OSC32_OUT), Y2.2
/RESET: C15.1, R24.1, S4.4, U2.7 (NRST)
/SWDCLK: J9.2, U2.37 (PA14)
/SWDIO: J9.3, U2.34 (PA13)
/VBAT: C21.1, CR2.1, TP11.1, U2.1 (VBAT), U6.1 (+)
GND: C1.1, C2.1, C3.2, C4.2, C6.2, C7.1, C8.1, C9.2, C10.1, C11.1, C12.1, C13.1, C14.1, C15.2, C18.2, C19.2, C20.2, C21.2, C22.1, C25.2, DS1.1 (GND), J2.1, J4.1, J7.1 (G), J7.2 (ID), J7.SH1 (SHIELD), J7.SH2 (SHIELD), J7.SH3 (SHIELD), J7.SH4 (SHIELD), J7.SH5 (SHIELD), J7.SH6 (SHIELD), J8.1, J9.1, J10.1, MT1.1, MT1.COM, MT1.S1 (SHIELD), MT1.S2 (SHIELD), MT2.1, MT2.COM, MT2.S1 (SHIELD), MT2.S2 (SHIELD), R11.1, R20.1, S4.2, S5.3, S6.3, S7.3, S8.3, TP12.1, U1.2, U2.8 (VSSA/VREF-), U2.23 (VSS_1), U2.35 (VSS_2), U2.47 (VSS_3), U3.2 (GND), U4.2 (GND), U5.2 (E), U6.2 (-), U8.1 (CLKIN), U8.9 (AD0)
unnamed: C5.1, D1.2, J3.2, R2.2
unnamed: C5.2, R5.1
unnamed: D1.1, J1.1, R5.2, R7.1
unnamed: D1.3, R2.1, U1.4
unnamed: J1.2, J3.1
unnamed: J2.4, R8.2
unnamed: J7.3 (D+), R26.1
unnamed: J7.4 (D-), R25.1
unnamed: LED1.1, R6.2
unnamed: LED2.1, R4.2
unnamed: LED3.1, R9.2
unnamed: LED4.1, R20.2
unnamed: LED5.1, R10.2
unnamed: LED6.1, R11.2
unnamed: R7.2, U1.6
unnamed: R8.1, U1.1
unnamed: R18.1, S7.1
unnamed: R19.1, S8.1
unnamed: C10.2, U4.4 (BP)
unnamed: LS1.N, TP5.1, U5.3 (C)
unnamed: C24.1, U8.20 (CPOUT)
unnamed: C23.2, U8.11 (FSYNC)
unnamed: C24.2, U8.18 (GND)
unnamed: C23.1, U8.10 (REGOUT)
