ymhtwe/stm32_timer_app/SW/expired/CubeProject/Core/Src/main.c

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
/* Includes ------------------------------------------------------------------*/
#include "main.h"
#include "i2c.h"
#include "spi.h"
#include "usart.h"
#include "OLED_2in42.h"


/* USER CODE BEGIN PM */
void AppMain(void);

void OLED_2in42_Init(void);
void OLED_2in42_Clear(void);
void OLED_2in42_Display(const UBYTE *Image);
/* USER CODE END PM */

SPI_HandleTypeDef hspi1;

TIM_HandleTypeDef htim2;
TIM_HandleTypeDef htim3;

UART_HandleTypeDef huart1;

void SystemClock_Config(void);

static void MX_GPIO_Init(void);
//static void MX_SPI1_Init(void);
static void MX_TIM2_Init(void);
static void MX_TIM3_Init(void);
static void MX_USART1_UART_Init(void);
/**
  * @brief  The application entry point.
  * @retval int
  */
int main(void)
{
  /* USER CODE BEGIN 1 */
	// Configure PA2 in input mode
    //GPIOA->MODER &= ~(GPIO_MODER_MODER2);
	// Configure PA2 as pull-up
    //GPIOA->PUPDR |= GPIO_PUPDR_PUPDR2_0;
    //GPIOA->PUPDR &= ~(GPIO_PUPDR_PUPDR2_1);
	
  /* USER CODE END 1 */

  /* MCU Configuration--------------------------------------------------------*/

  /* Reset of all peripherals, Initializes the Flash interface and the Systick. */
  HAL_Init();

  /* Configure the system clock */
  SystemClock_Config();

  /* Initialize all configured peripherals */
  MX_GPIO_Init();
  MX_I2C1_Init();
  MX_SPI1_Init();
  MX_USART2_UART_Init();
  
  //MX_SPI1_Init();
  //MX_TIM2_Init();
  //MX_TIM3_Init();
  //MX_USART1_UART_Init();
  /* Infinite loop */
  /* USER CODE BEGIN WHILE */
	//AppMain();
  while (1)
  {
    /* USER CODE END WHILE */
    OLED_2in42_test();
    /* USER CODE BEGIN 3 */
  }
  /* USER CODE END 3 */
}//end of main()




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
