ymhtwe/stm32_timer_app/SW/CubeProject/CubeProject/user/OLED/OLED_2in42.h

/*****************************************************************************
* | File      	:   OLED_2in42.h
* | Author      :   Waveshare team
* | Function    :   1.54inch OLED Drive function
* | Info        :
*----------------
* |	This version:   V1.0
* | Date        :   2022-06-20
* | Info        :
* -----------------------------------------------------------------------------
#
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
******************************************************************************/
#ifndef __OLED_2IN42_H
#define __OLED_2IN42_H		

#include "DEV_Config.h"
//#include "Soft_IIC.h"

/********************************************************************************
function:	
		Define the full screen height length of the display
********************************************************************************/
#define OLED_2IN42_WIDTH  64//OLED width
#define OLED_2IN42_HEIGHT 128 //OLED height

/********************************************************************************
function:	
			Macro definition variable name
********************************************************************************/
void OLED_2in42_Init(void);
void OLED_2in42_Clear(void);
void OLED_2in42_Display(const UBYTE *Image);
//float radians(float radian);
#endif  
	 
