ymhtwe/stm32_timer_app/SW/expired/CubeProject/Core/Src/OLED_2in42_test.c

/*****************************************************************************
* | File      	:   OLED_2in42_test.c
* | Author      :   Waveshare team
* | Function    :   2.42inch OLED test demo
* | Info        :
*----------------
* |	This version:   V1.0
* | Date        :   2022-06-20
* | Info        :
* -----------------------------------------------------------------------------
#
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
******************************************************************************/
#include "test.h"
#include "OLED_2in42.h"
#include "math.h"

int OLED_2in42_test(void)
{
	printf("2.42inch OLED test demo\n");
	if(System_Init() != 0) {
		return -1;
	}
	  
	if(USE_IIC) {
		printf("Only USE_SPI_4W or USE_IIC_SOFT, Please revise DEV_Config.h !!!\r\n");
		return -1;
	}
	
	printf("OLED Init...\r\n");
	OLED_2in42_Init();
	Driver_Delay_ms(500);	
	// 0.Create a new image cache
	UBYTE *BlackImage;
	UWORD Imagesize = ((OLED_2IN42_WIDTH%8==0)? (OLED_2IN42_WIDTH/8): (OLED_2IN42_WIDTH/8+1)) * OLED_2IN42_HEIGHT;
	if((BlackImage = (UBYTE *)malloc(Imagesize)) == NULL) {
			printf("Failed to apply for black memory...\r\n");
			return -1;
	}
	printf("Paint_NewImage\r\n");
	Paint_NewImage(BlackImage, OLED_2IN42_WIDTH, OLED_2IN42_HEIGHT, 270, BLACK);	

	printf("Drawing\r\n");
	//1.Select Image
	Paint_SelectImage(BlackImage);
	Driver_Delay_ms(500);
	Paint_Clear(BLACK);
	
		// 2.Drawing on the image		
		printf("Drawing:page 1\r\n");
		Paint_DrawPoint(20, 10, WHITE, DOT_PIXEL_1X1, DOT_STYLE_DFT);
		Paint_DrawPoint(30, 10, WHITE, DOT_PIXEL_2X2, DOT_STYLE_DFT);
		Paint_DrawPoint(40, 10, WHITE, DOT_PIXEL_3X3, DOT_STYLE_DFT);
		Paint_DrawLine(10, 10, 10, 20, WHITE, DOT_PIXEL_1X1, LINE_STYLE_SOLID);
		Paint_DrawLine(20, 20, 20, 30, WHITE, DOT_PIXEL_1X1, LINE_STYLE_SOLID);
		Paint_DrawLine(30, 30, 30, 40, WHITE, DOT_PIXEL_1X1, LINE_STYLE_DOTTED);
		Paint_DrawLine(40, 40, 40, 50, WHITE, DOT_PIXEL_1X1, LINE_STYLE_DOTTED);
		Paint_DrawCircle(60, 30, 15, WHITE, DOT_PIXEL_1X1, DRAW_FILL_EMPTY);
		Paint_DrawCircle(100, 40, 20, WHITE, DOT_PIXEL_1X1, DRAW_FILL_FULL);			
		Paint_DrawRectangle(50, 30, 60, 40, WHITE, DOT_PIXEL_1X1, DRAW_FILL_EMPTY);
		Paint_DrawRectangle(90, 30, 110, 50, BLACK, DOT_PIXEL_1X1, DRAW_FILL_FULL);		
		// 3.Show image on page1
		OLED_2in42_Display(BlackImage);
		Driver_Delay_ms(2000);			
		Paint_Clear(BLACK);
		
		// Drawing on the image
		printf("Drawing:page 2\r\n");			
		Paint_DrawString_EN(10, 0, "waveshare", &Font16, WHITE, WHITE);
		Paint_DrawString_EN(10, 17, "hello world", &Font8, WHITE, WHITE);
		Paint_DrawNum(10, 30, 123.456789, &Font8, 4, WHITE, WHITE);
		Paint_DrawNum(10, 43, 987654, &Font12, 5, WHITE, WHITE);
		// Show image on page2
		OLED_2in42_Display(BlackImage);
		Driver_Delay_ms(2000);	
		Paint_Clear(BLACK);		
		
		// Drawing on the image
		printf("Drawing:page 3\r\n");
		Paint_DrawString_CN(10, 0,"���Abc", &Font12CN, WHITE, WHITE);
		Paint_DrawString_CN(0, 20, "΢ѩ����", &Font24CN, WHITE, WHITE);
		// Show image on page3
		OLED_2in42_Display(BlackImage);
		Driver_Delay_ms(2000);		
		Paint_Clear(BLACK);	

		// Drawing on the image
		printf("Drawing:page 4\r\n");
		OLED_2in42_Display(gImage_1in3);
		Driver_Delay_ms(2000);		
		Paint_Clear(BLACK);	
		
		
		return 0;
}
