ymhtwe/stm32_timer_app/(commit log)

2023-12-11 Create Temp Control Timer.pdf
    draft idea
2023-12-11 Create README.md
    stm32 timer module
2023-12-11 KiCad PCB Project
    creating blank PCB project file
    [stm32_timer_app.kicad_pcb, stm32_timer_app.kicad_sch]
2023-12-16 schematic design
    schematic design
    [1050170001--3DModel-STEP-1.STEP, 105164-0001.step, 1571527-1.step, BTA10-600BRG.STEP, CONN_61300411121_WRE.step, LD03ZD475MAB2A.step, MOC3041.step, MOC3041SM.step]
2023-12-16 schematic design
    added schematic for 3v3 regulator, reset switch, micro USB and two led
    [CONN_PH2-06-UA_ADM.step, LED_150060GS75000_WRE.step, stm32_timer_app.kicad_pcb, stm32_timer_app.kicad_sch]
2023-12-17 schematic design
    schematic design revision 1
    [691213710002.stp, ABL-8.000MHZ-B2.step, ABS25-32.768KHZ-6-4-T.step, CAP_ECWFD_FORMING_Q__12_6LX06_9TX09_9H_PAN.step, RES_OY_OHM.step, SOD123_DIO.step, TC33X-2-102E.step, stm32_timer_app.kicad_pcb]
2023-12-20 replace 16x2 lcd with 2.4" OLED foot print
    replace 16x2 lcd with 2.4" OLED foot print
    [AOM12864A0-1.54WW-ANO.step, stm32_timer_app.kicad_pcb, stm32_timer_app.kicad_sch]
2023-12-21 update schematic
    update schematic and foot print / 3D body libraries
    [ABLS-8.000MHZ-B2-T.step, BTA16-600B.step, MSS6-V-T_R.step, OLED 2.42 12864 v7.step, TL3342F160QG.step, stm32_timer_app.kicad_pcb, stm32_timer_app.kicad_sch]
2023-12-28 schematic update
    mcu changed
    [SMTU2032.step, STM32F303C8T6.stp, stm32_timer_app.kicad_pcb, stm32_timer_app.kicad_sch]
2024-01-13 final schematic
    [54101-G0502LF.step, 75160-196-03LF.step, 78511-202.step, PH1RB-04-UA.stp, PH1RB-05-UA.STL, PH1RB-05-UA_TEMP..stp, QFN24_4X4X0P9_IVS.step, RC1206N_YAG.step]
2024-01-28 final PCB
    Final PCB
